ZONESTAR3D/Control-Board/readme.md

## ZONESTAR 3D Printer Control board documents 
### [8-bit Control board - ZMIB and ZRIB](./8bit/)
### [32-bitControl board - ZM3E2 and ZM3E4](./32bit/)
### [ZONESTAR 3D Printer LCD Screen](./LCD%20Screen/)
