ZONESTAR3D/Control-Board/8bit/readme.md

## ZMIB 3d printer control board
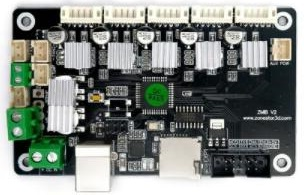
[picture p1: 8bit/ZMIB.jpg]
ZMIB
    
- **[:arrow_down: Documents for ZMIB 3d printer control board](./ZMIB.zip)**
- **:file_folder: Firmware**     
If you need to compile your own firmware, you can refer to the firmware source code of our machine which used ZMIB control board.
  - **[Firmware for Z5](https://github.com/ZONESTAR3D/Firmware/blob/master/Z5/ZMIB)**   
  - **[Firmware for Z5X](https://github.com/ZONESTAR3D/Firmware/tree/master/Z5X/ZMIBV2)**   
  - **[Firmware for Z6](https://github.com/ZONESTAR3D/Firmware/tree/master/Z6/ZMIBV2)**    

----
## ZRIB 3d printer control board
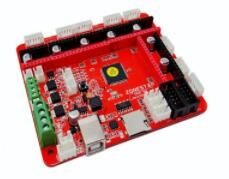
[picture p2: 8bit/ZRIB.jpg]
ZRIB
    
- **[:arrow_down: Documents for ZRIB 3d printer control board](./ZRIB.zip)**   
- **:file_folder: Firmware**     
If you need to compile your own firmware, you can refer to the firmware source code of our machine which used ZRIB control board.
  - **[Firmware for Z8T](https://github.com/ZONESTAR3D/Firmware/tree/master/Z8/Z8T/ZRIBV6(default))**   
  - **[Firmware for Z9M3](https://github.com/ZONESTAR3D/Firmware/tree/master/Z9/Z9M3/ZRIBV6)**    

----
## USB to UART Driver
Both ZMIB and ZRIB used a CP2102 "USB to UART Bridge Virtual COM Port" chip, when you connect the control board to the USB port of the PC, you may need to install its driver.
#### [Driver download link](https://www.silabs.com/developers/usb-to-uart-bridge-vcp-drivers)
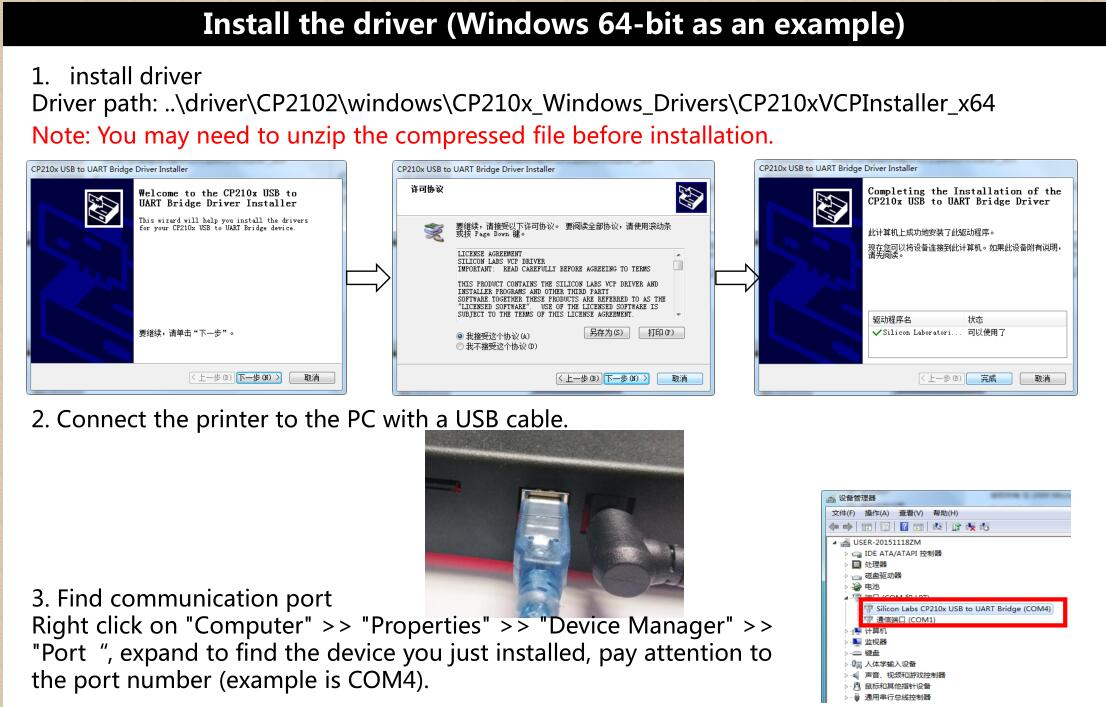
[picture p3: 8bit/Install_Driver.jpg]


----
## Upload Firmware
You can upload firmware to the ZRIB and ZMIB control boards by USB port of the PC. For details, please refer to this link: https://github.com/ZONESTAR3D/Firmware/tree/master/Firmware_Upload_tool_for_ZRIB_ZMIB
