ZONESTAR3D/Control-Board/32bit/ZM3E2/readme.md

# ZM3E2  
## Board Size  
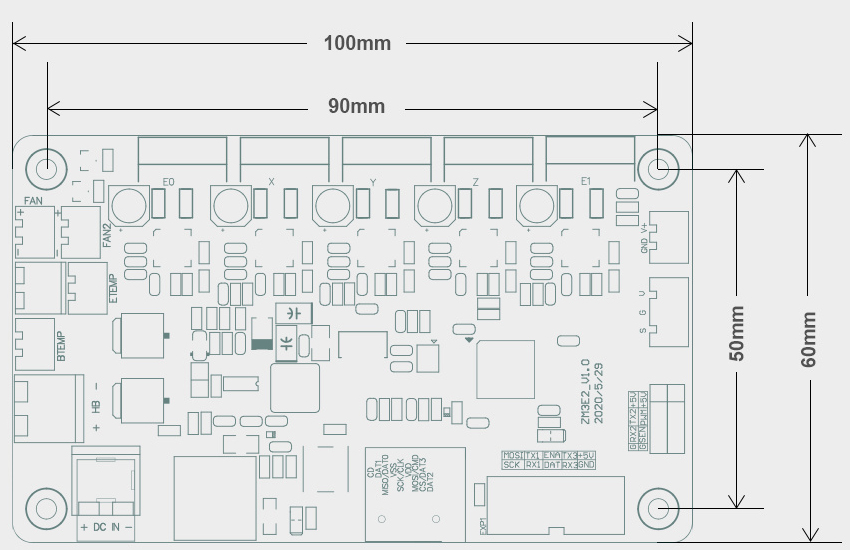
[picture p6: 32bit/ZM3E2/Size_ZM3E2.jpg]
Size
  

## Schematic diagram [:arrow_down: PDF](./SCH_ZM3E2V1.pdf)  
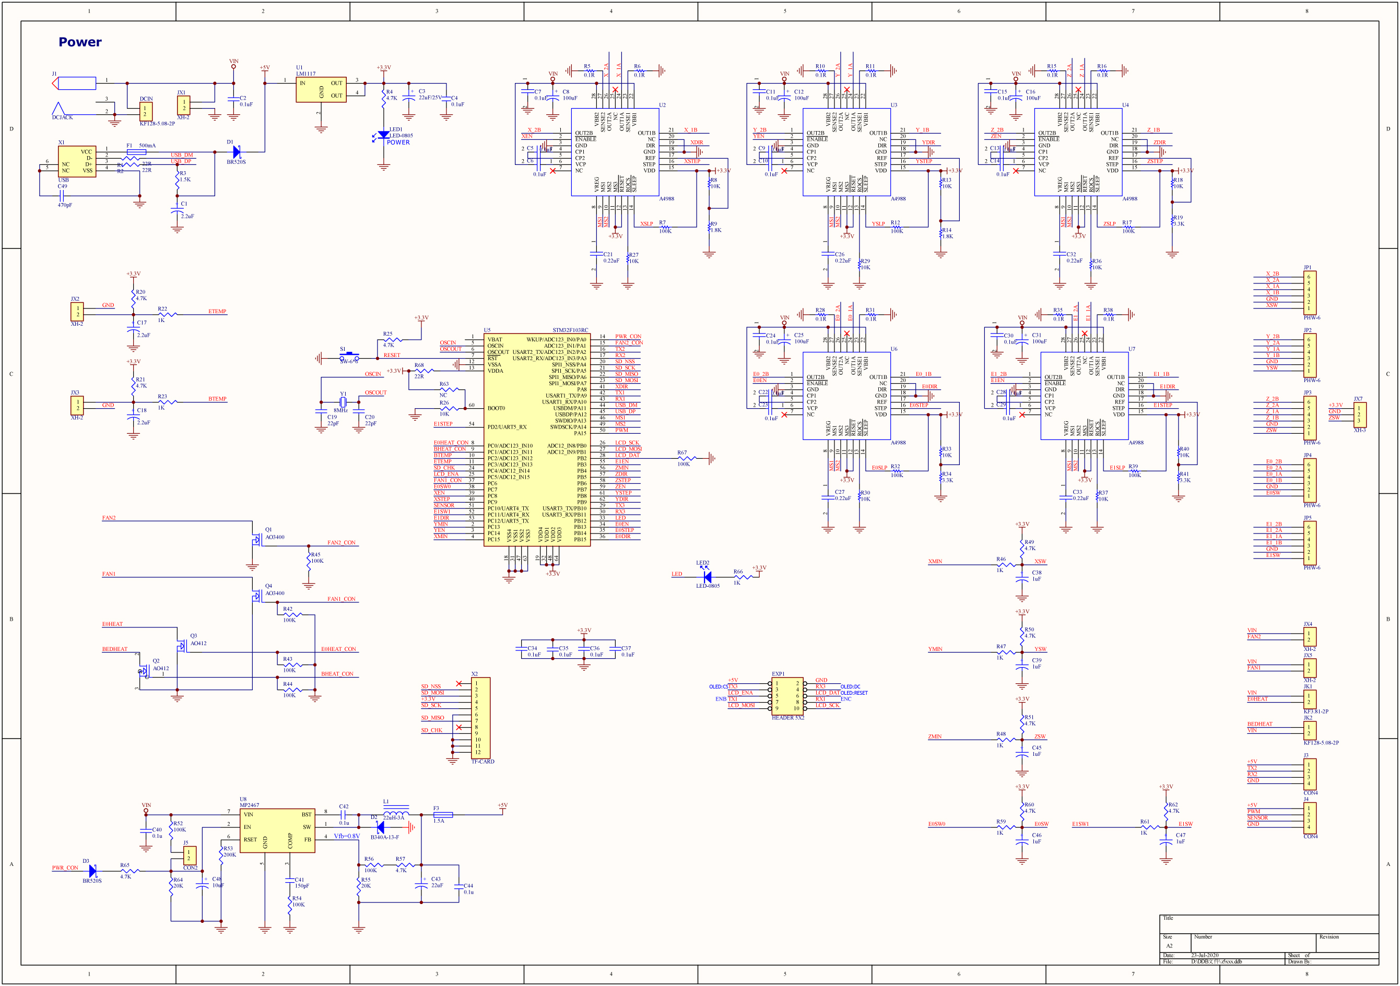
[picture p7: 32bit/ZM3E2/SCH_ZM3E2V1.jpg]
schematic diagram


## Pin out [:arrow_down: PDF](./PINOUT_ZM3E2V1.pdf)
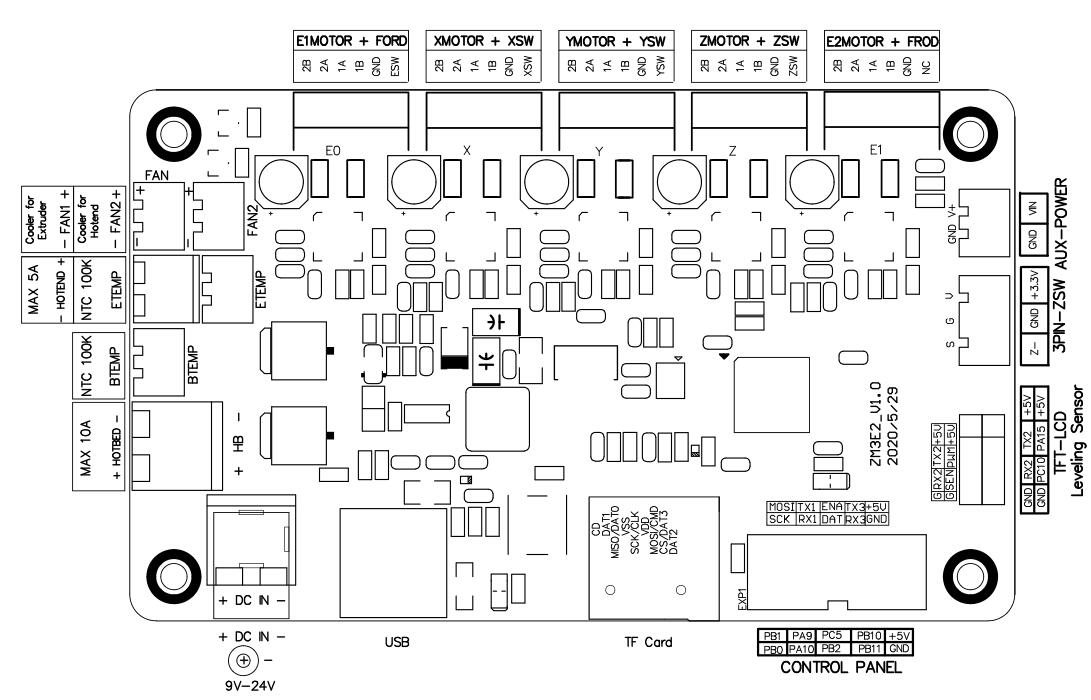
[picture p8: 32bit/ZM3E2/PINOUT_ZM3E2V1.jpg]
PINOUT
  

## PCB
### Designator   [:arrow_down: PDF](./designtor.pdf)
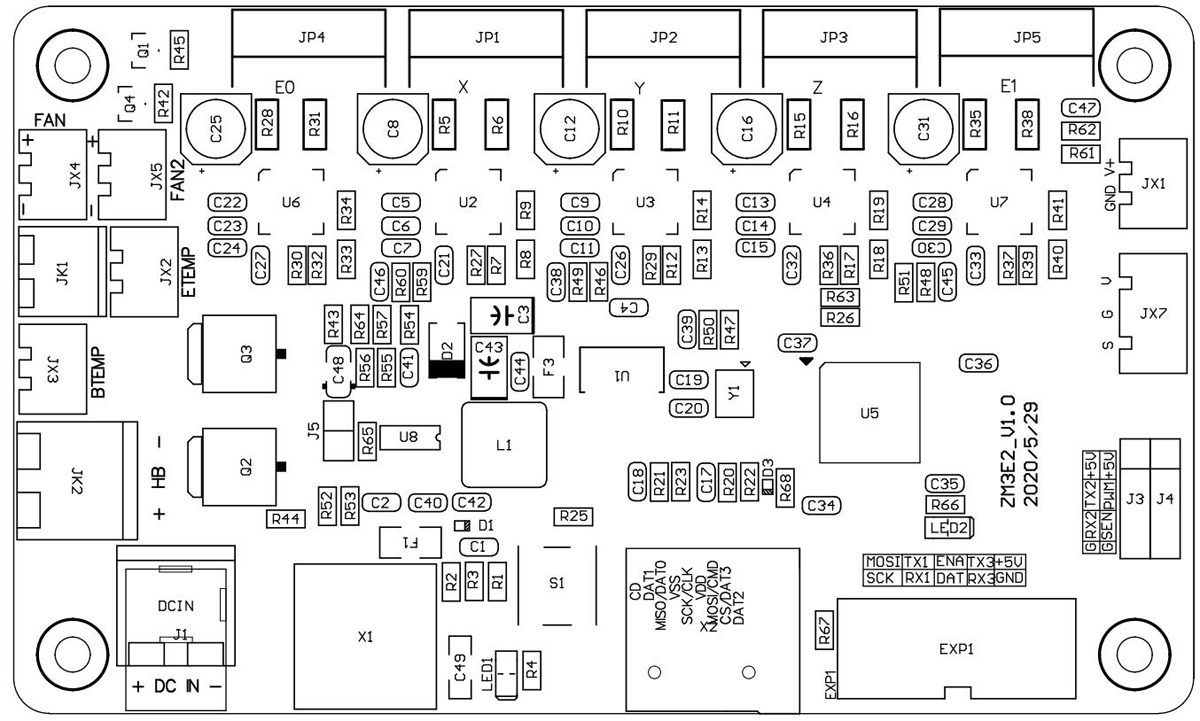
[picture p9: 32bit/ZM3E2/designator.jpg]
Designator
  
### Parts [:blue_book:PDF](./parts.pdf)
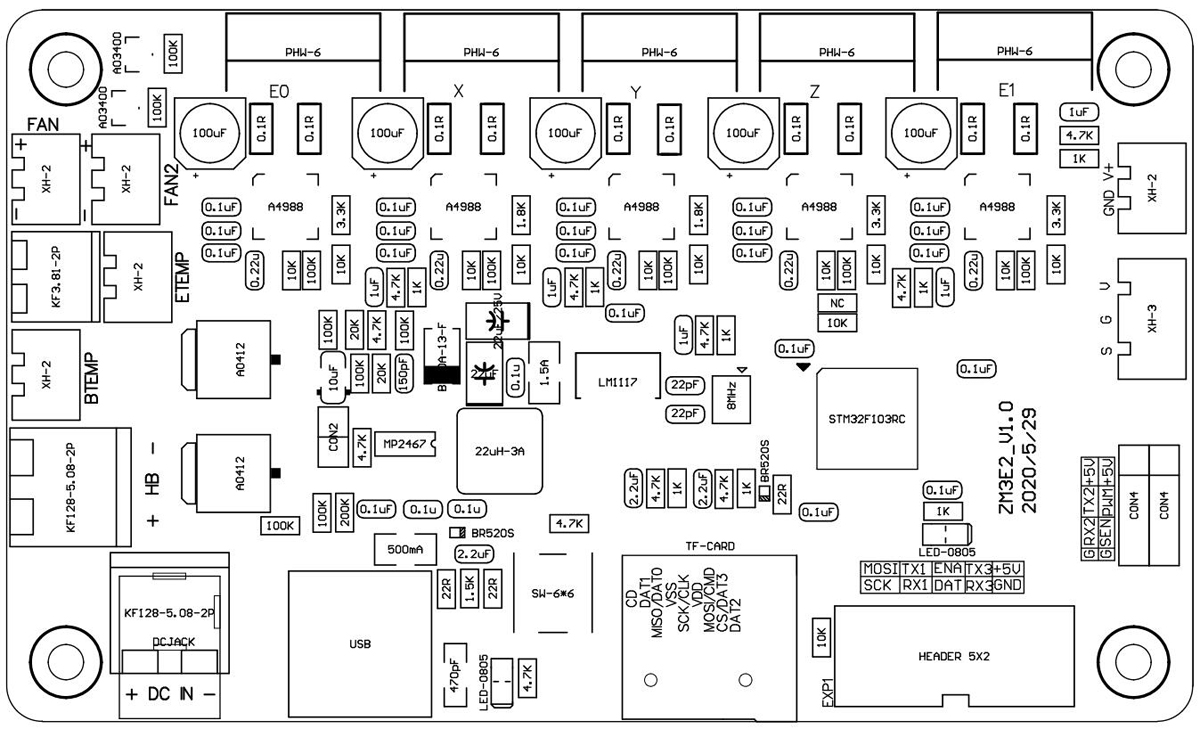
[picture p10: 32bit/ZM3E2/parts.jpg]
Parts
  

## Pin define  
please refer to the file: [***pins_ZM3E2_V1_0.h***](https://github.com/ZONESTAR3D/Control-Board/blob/main/32bit/ZM3E2/pins_ZM3E2_V1_0.h)  
## Wiring reference
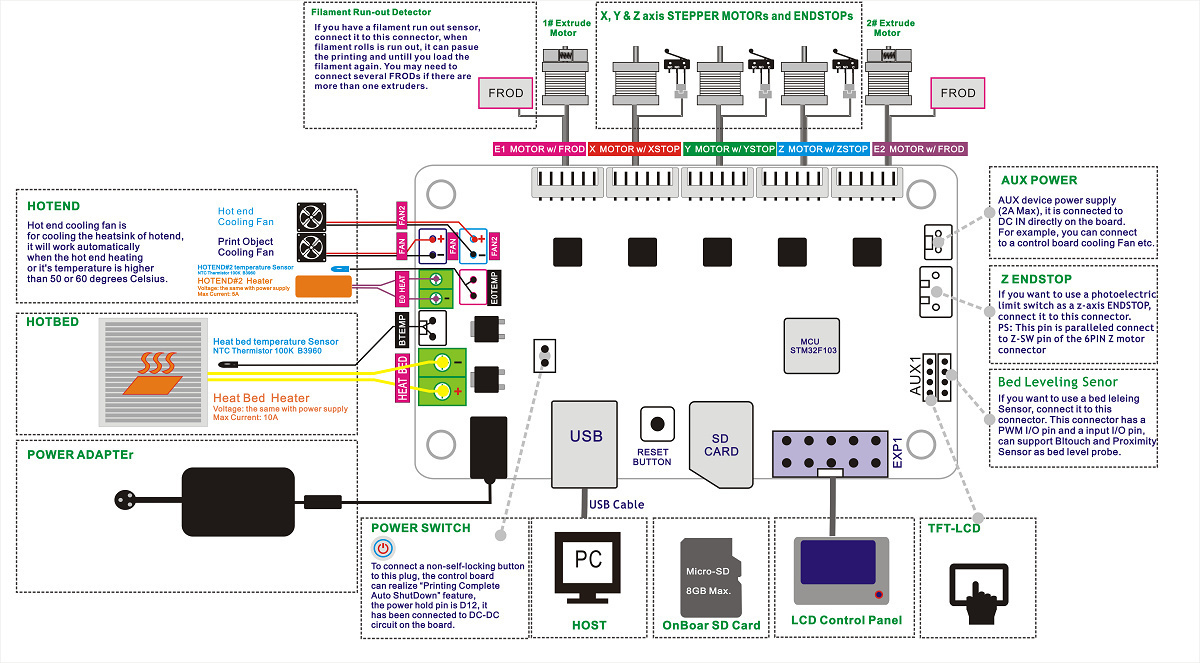
[picture p11: 32bit/ZM3E2/Wiring_ZM3E2V1.jpg]
Wiring
  

## Bootloader
### How to programming bootloader of the ZM3E2 control board
### [:arrow_down: Download ZM3E2 bootloader file](./ZM3E2_Bootloader.zip)
The steps for programming the bootloader are as follows:    
1. Short R63 (BOOT0 Pin of the MCU) with tweezers and then power on the control board.
2. Release the tweezers for shorting R63.
3. Programming the bootloader.     

For tools and detailed instructions, please refer to [:book: **the instructions for programming bootloader for ZM3E4**](https://github.com/ZONESTAR3D/Control-Board/blob/main/32bit/ZM3E4/flashBootloader/readme.md).

#### The position of R63 on the control board
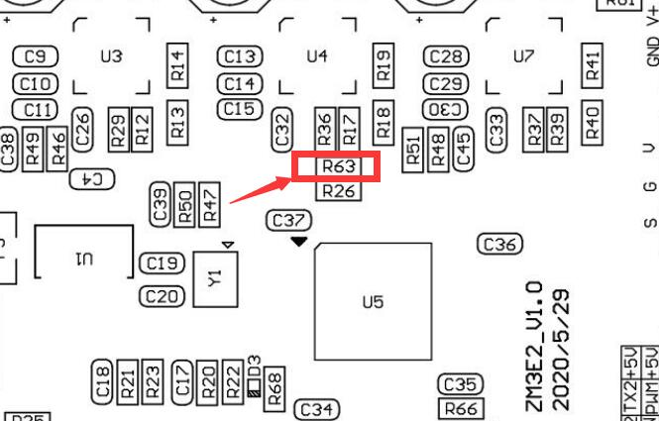
[picture p12: 32bit/ZM3E2/R63.jpg]

#### UART1 pins on the control board
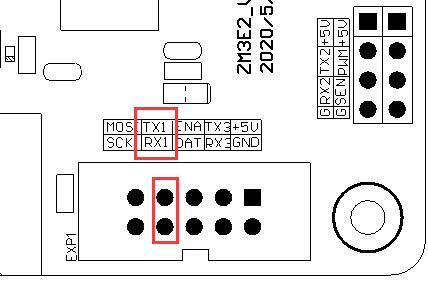
[picture p13: 32bit/ZM3E2/UART1.jpg]
