ZONESTAR3D/Control-Board/32bit/ZM3E4/flashBootloader/5.jpg

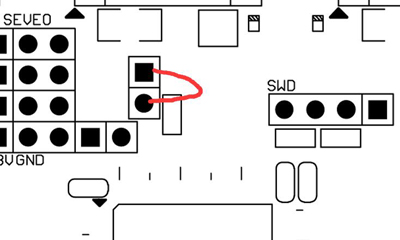
32bit/ZM3E4/flashBootloader/5.jpg
