ZONESTAR3D/Control-Board/32bit/ZM3E4/ZM3E4V1/PCB_BOTTOM_ZM3E4_V1.jpg

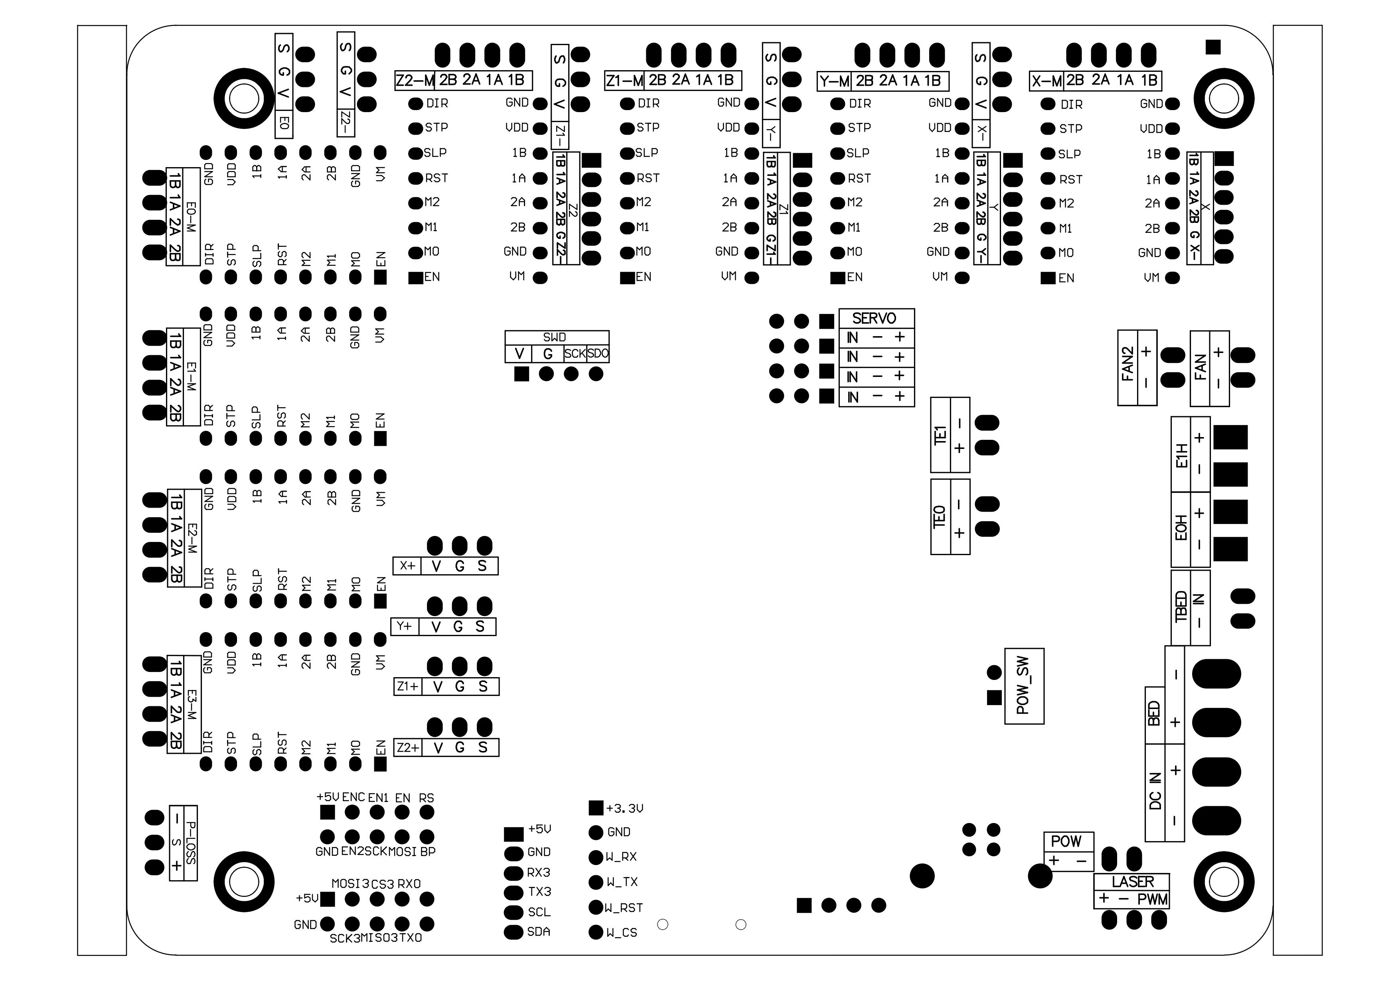
32bit/ZM3E4/ZM3E4V1/PCB_BOTTOM_ZM3E4_V1.jpg
