ZONESTAR3D/Control-Board/32bit/ZM3E4/ZM3E4V20/Designator_ZM3E4_V2.jpg

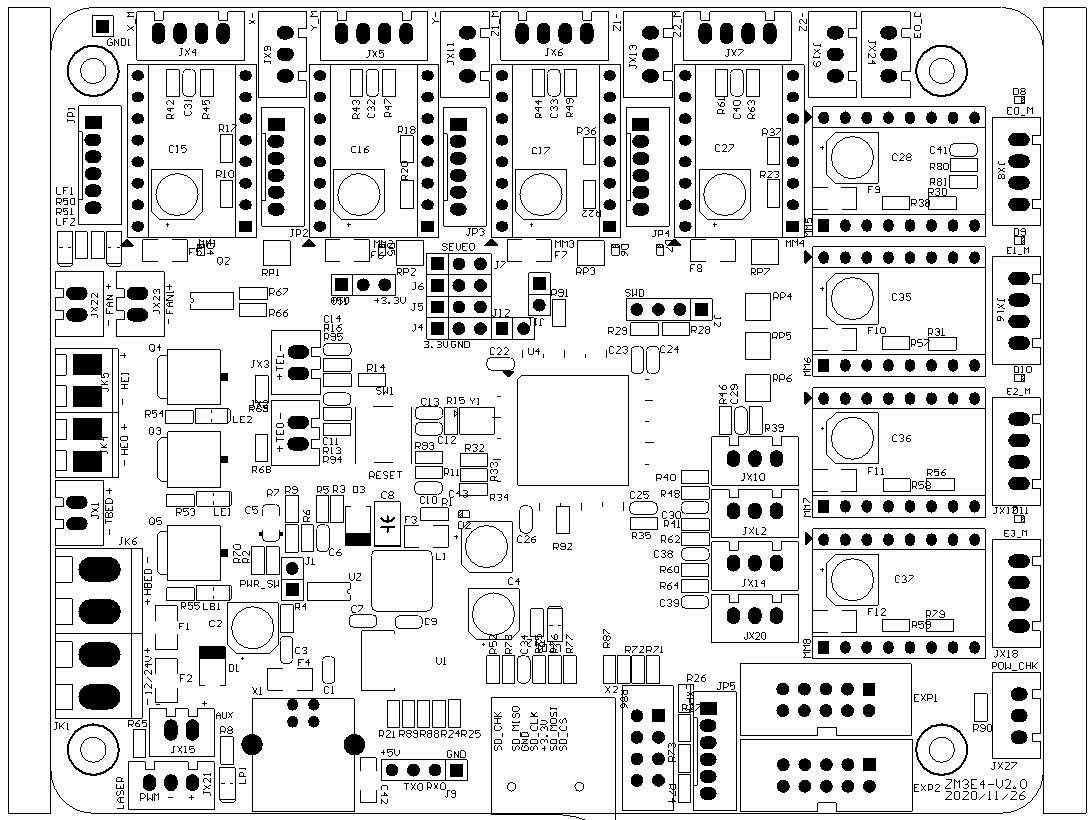
32bit/ZM3E4/ZM3E4V20/Designator_ZM3E4_V2.jpg
