ZONESTAR3D/Control-Board/32bit/ZM3E4/ZM3E4V20/PCB_TOP_ZM3E4_V20.jpg

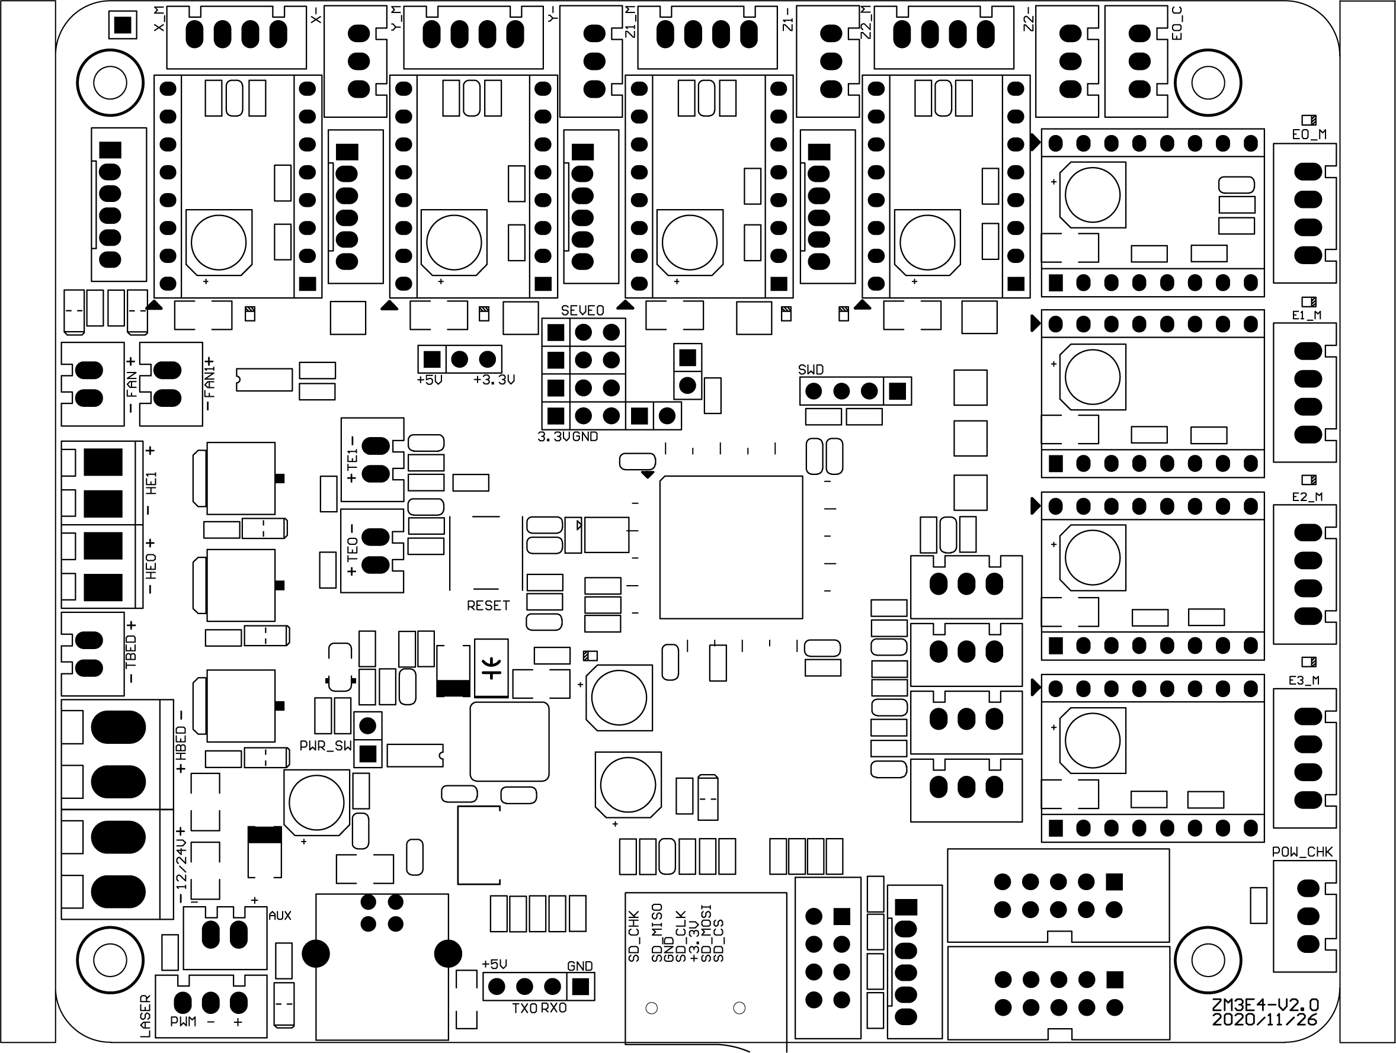
32bit/ZM3E4/ZM3E4V20/PCB_TOP_ZM3E4_V20.jpg
