ZONESTAR3D/Control-Board/32bit/ZM3E4/ZM3E4V20/SCH_ZM3E4V20.jpg

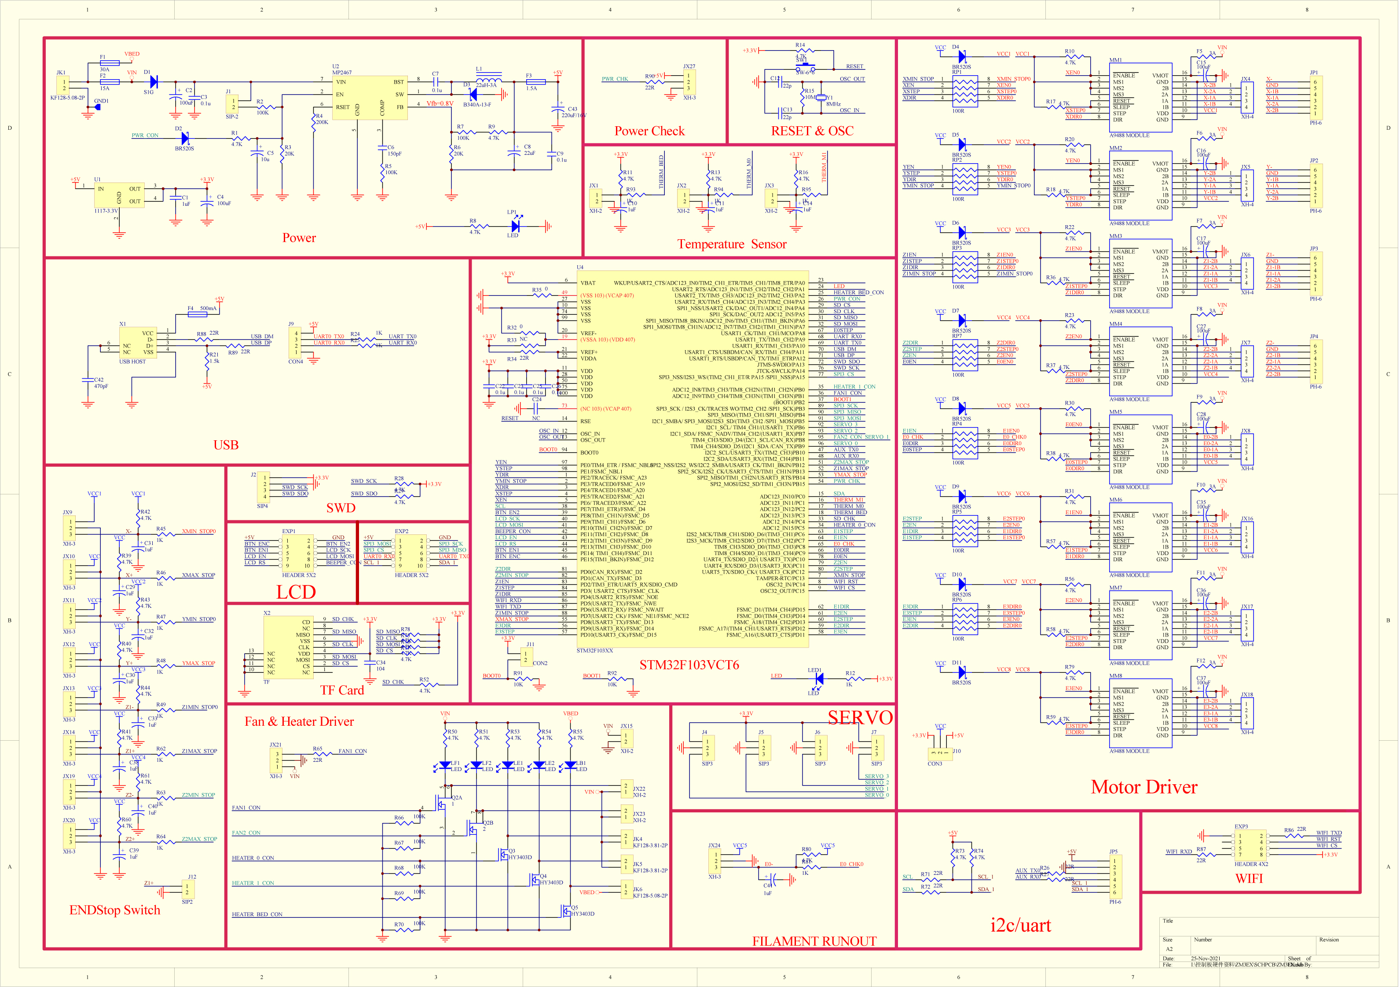
32bit/ZM3E4/ZM3E4V20/SCH_ZM3E4V20.jpg
