ZONESTAR3D/Control-Board/32bit/ZM3E4/zm3e4.stp

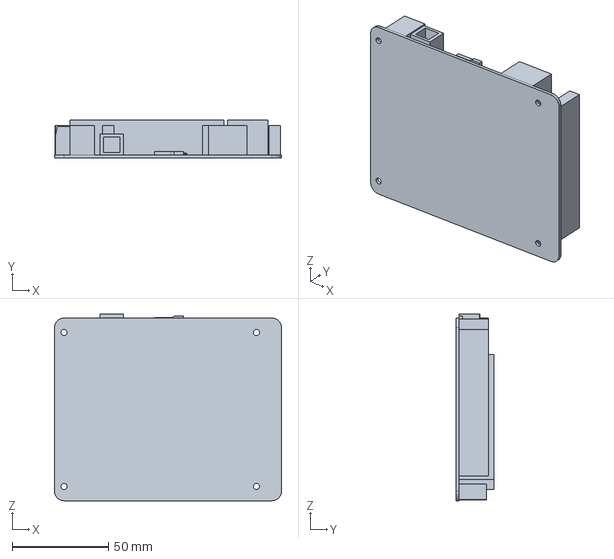
[picture p38: CAD file, 2021-11-25, last stored version]
32bit/ZM3E4/zm3e4.stp
118.0 x 20.0 x 97.0 mm
