ZONESTAR3D/Control-Board/32bit/ZM3E4/Wiring/ZM3E4_P802_Wiring_Diagram.jpg

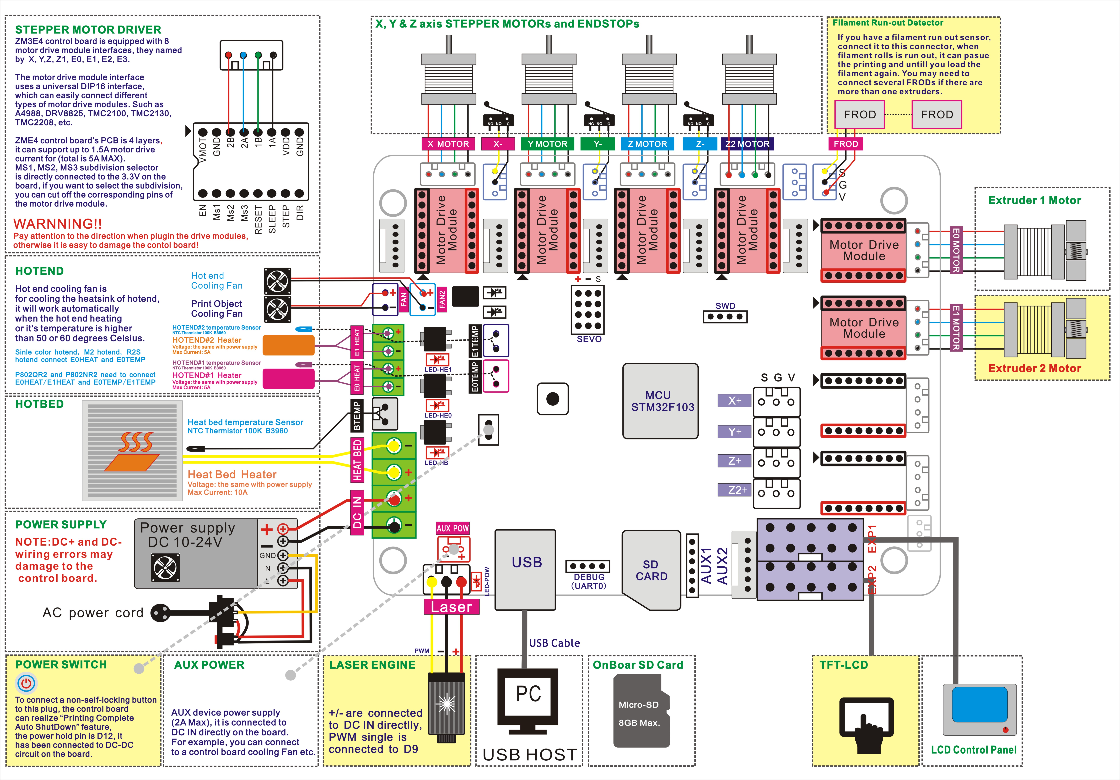
32bit/ZM3E4/Wiring/ZM3E4_P802_Wiring_Diagram.jpg
