ZONESTAR3D/Control-Board/32bit/ZM3E4/Wiring/ZM3E4_Wiring_Diagram_4PINMotorCable.jpg

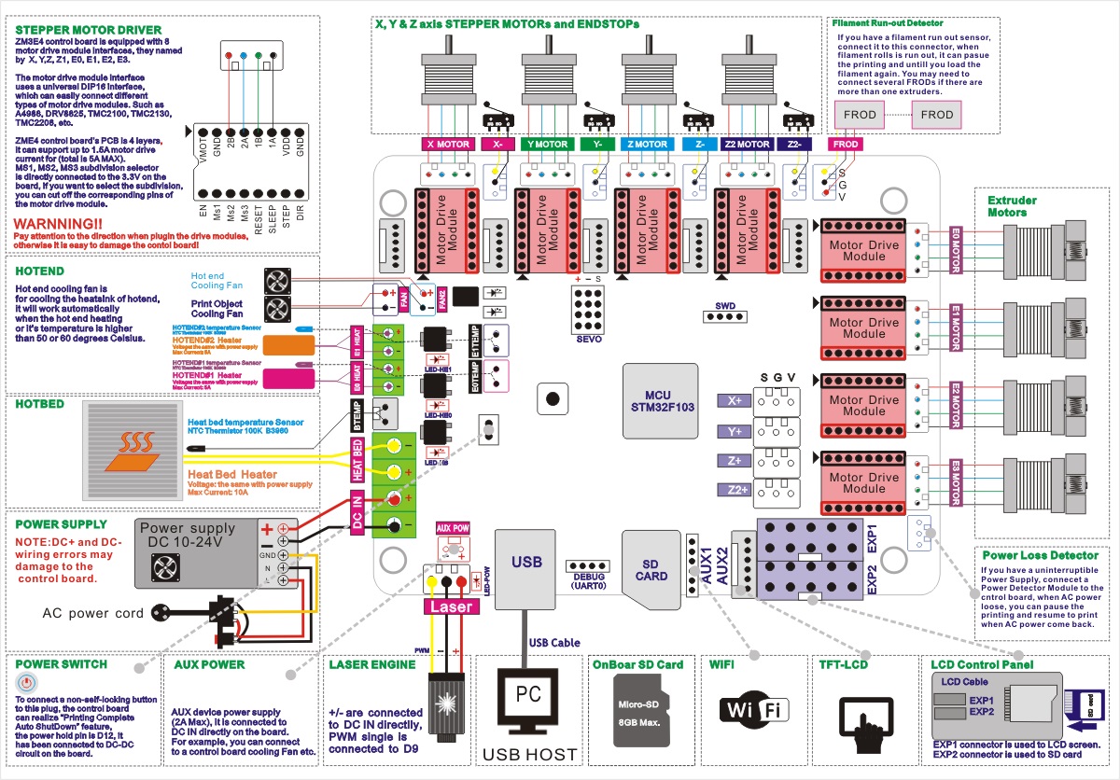
32bit/ZM3E4/Wiring/ZM3E4_Wiring_Diagram_4PINMotorCable.jpg
