ZONESTAR3D/Control-Board/32bit/ZM3E4/ZM3E4V3/ZM3E4V3_SCH.pdf

200K | Vfb=0.8V

# RESET & OSC

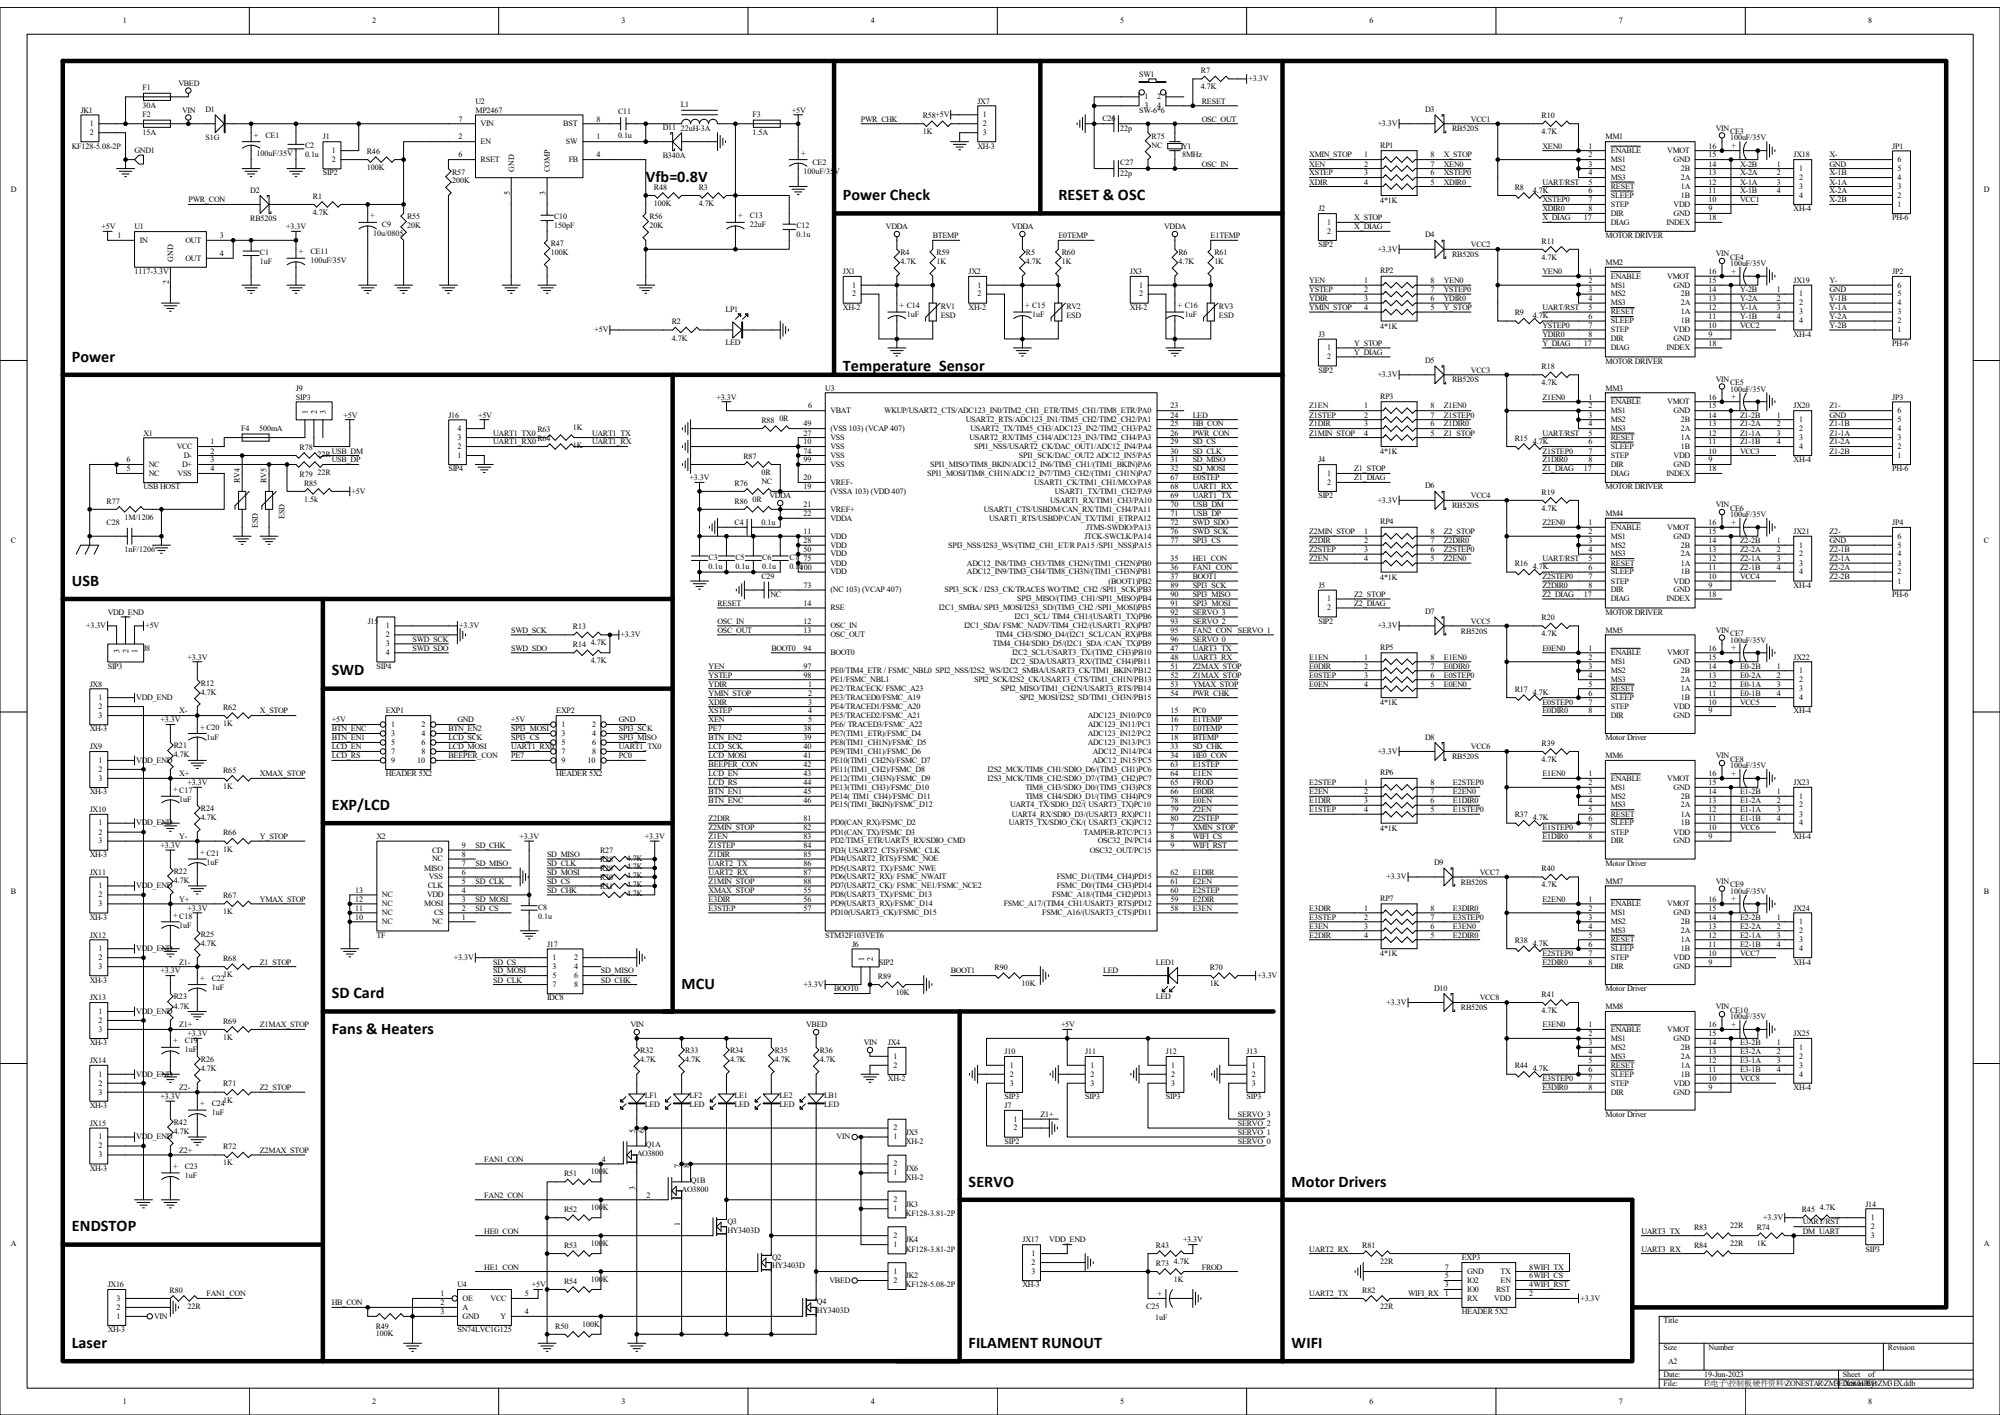
[picture p41: page 1]
