ZONESTAR3D/Control-Board/32bit/ZM3E4/ZM3E4V20/SCH_ZM3E4V20.pdf

### Vfb=0.8V

# RESET & OSC

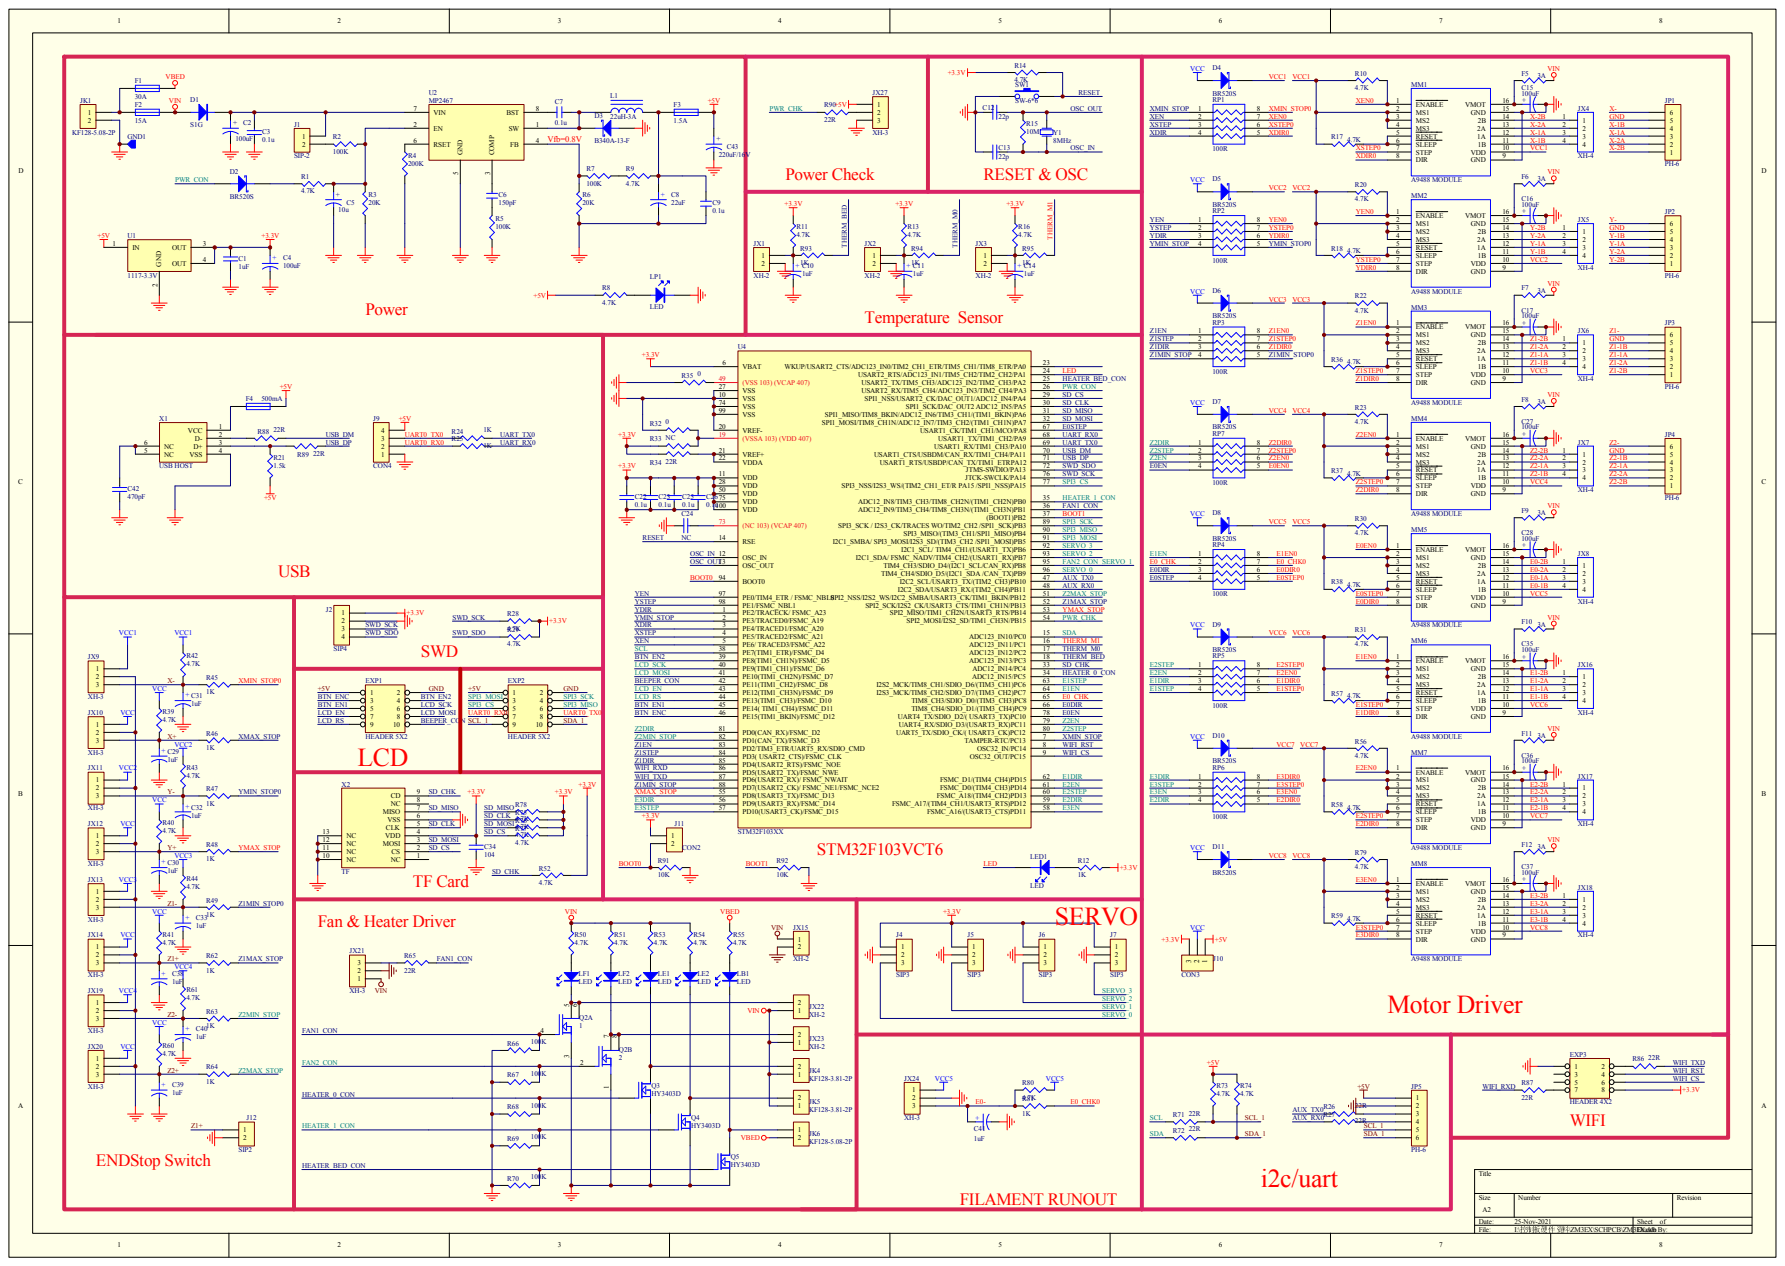
[picture p42: page 1]
