ZONESTAR3D/Control-Board/32bit/ZM3E4/ZM3E4V21/SCH_ZM3E4V21.pdf

### Vfb=0.8V

# RESET & OSC

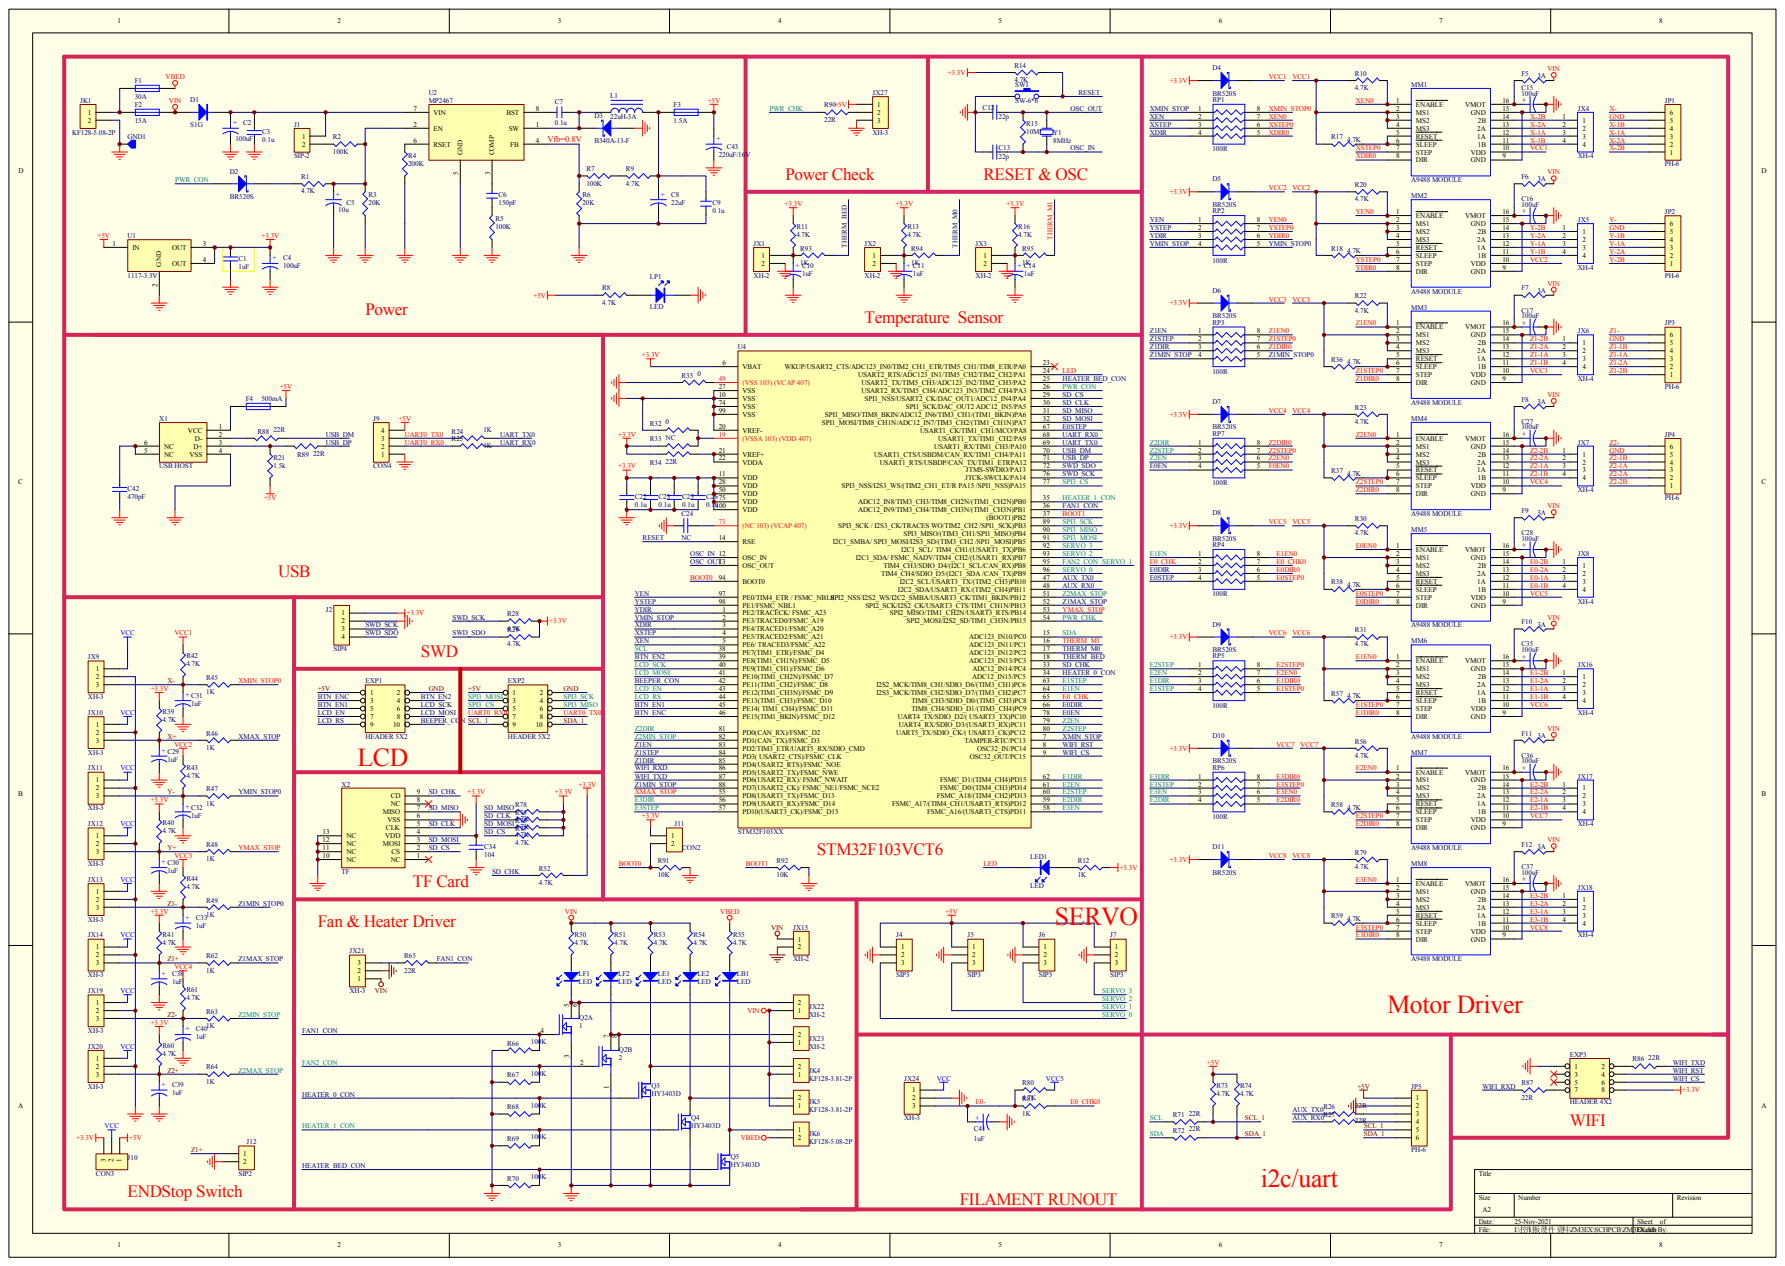
[picture p43: page 1]
