ZONESTAR3D/Control-Board/32bit/ZM3E2/designator.pdf

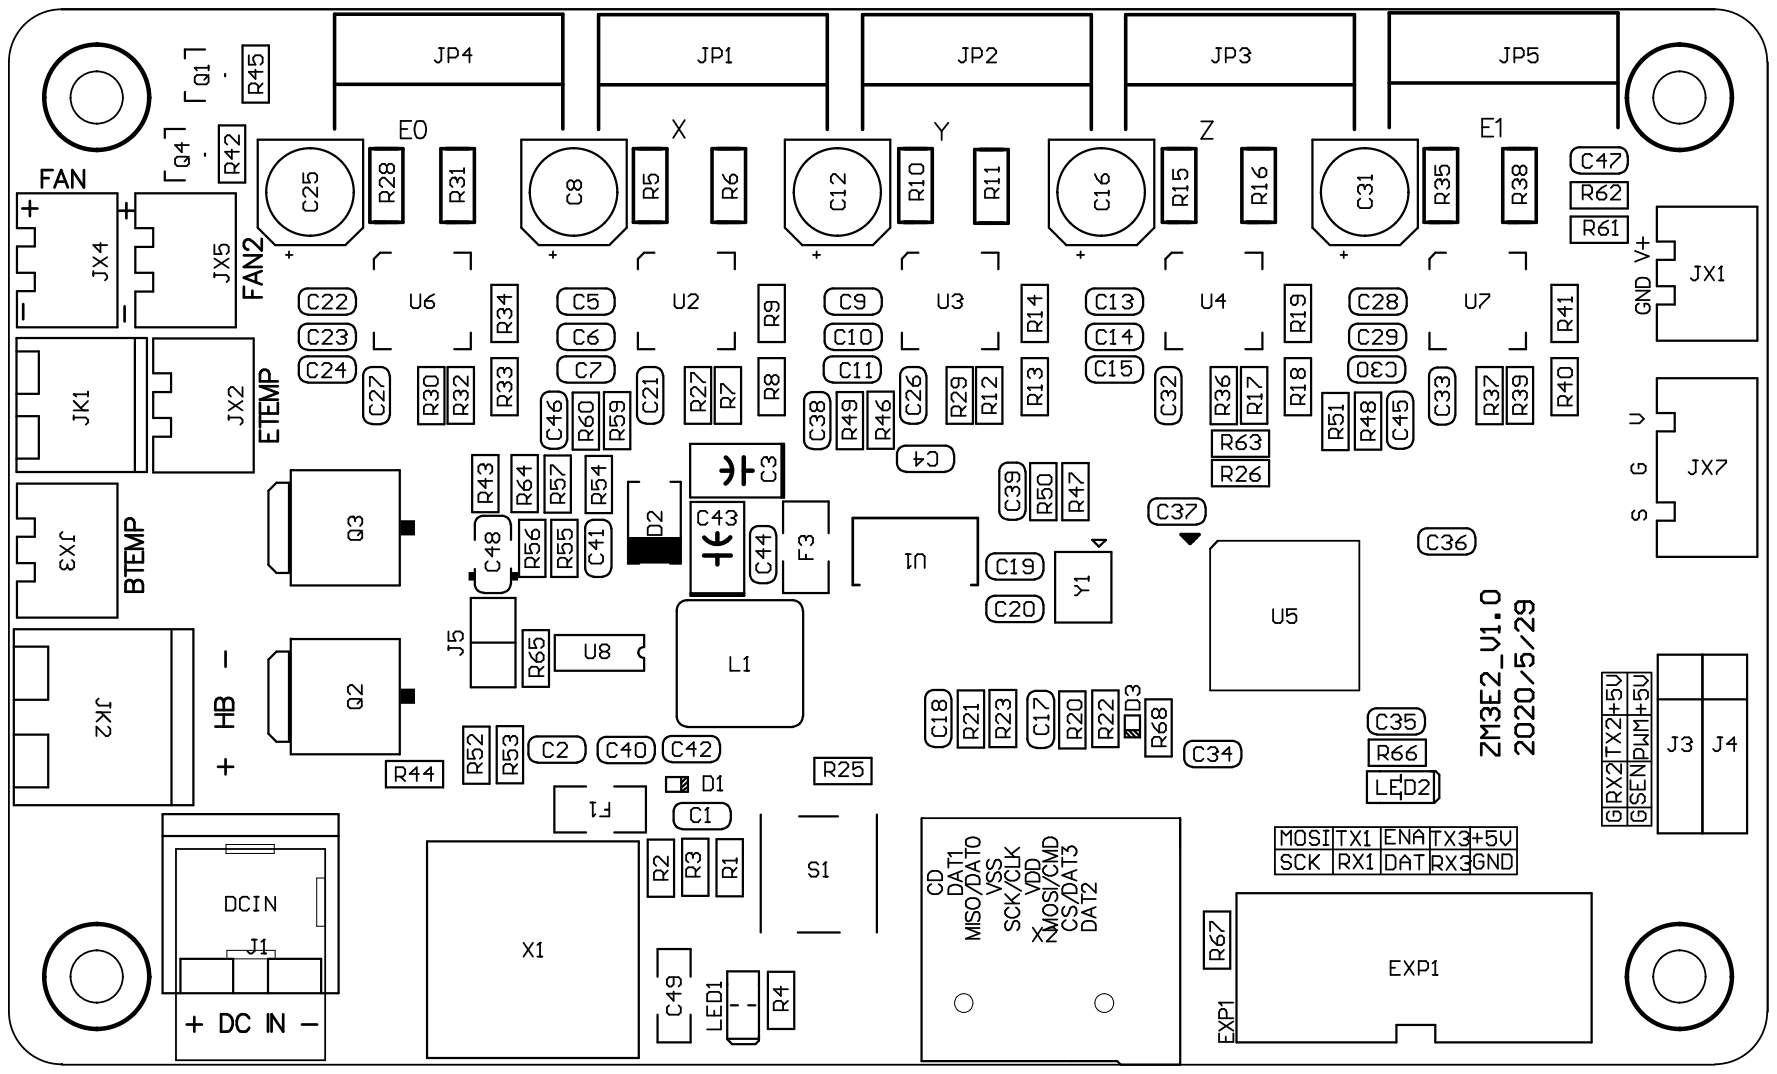
[picture p44: page 1]
