ZONESTAR3D/Control-Board/32bit/ZM3E2/parts.pdf

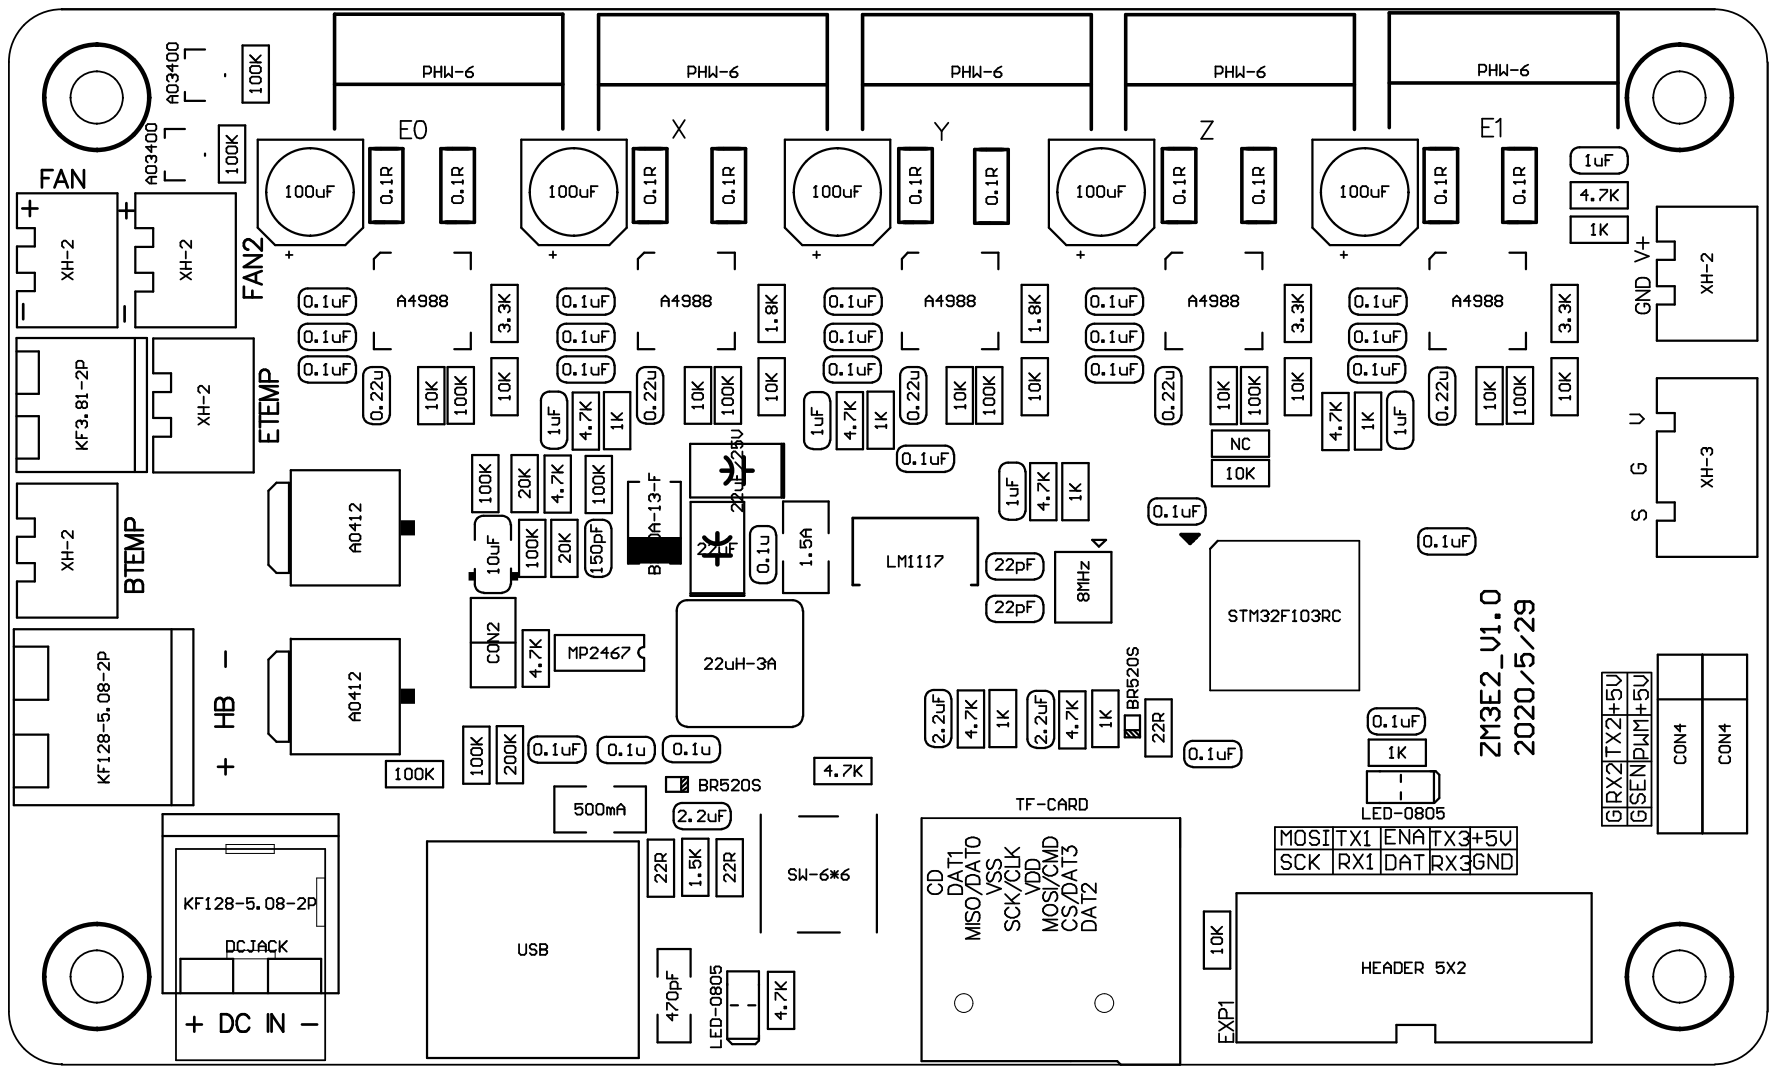
[picture p45: page 1]
