ZONESTAR3D/Control-Board/32bit/ZM3E4/ZM3E4V3/ZM3E4V3_Designator.pdf

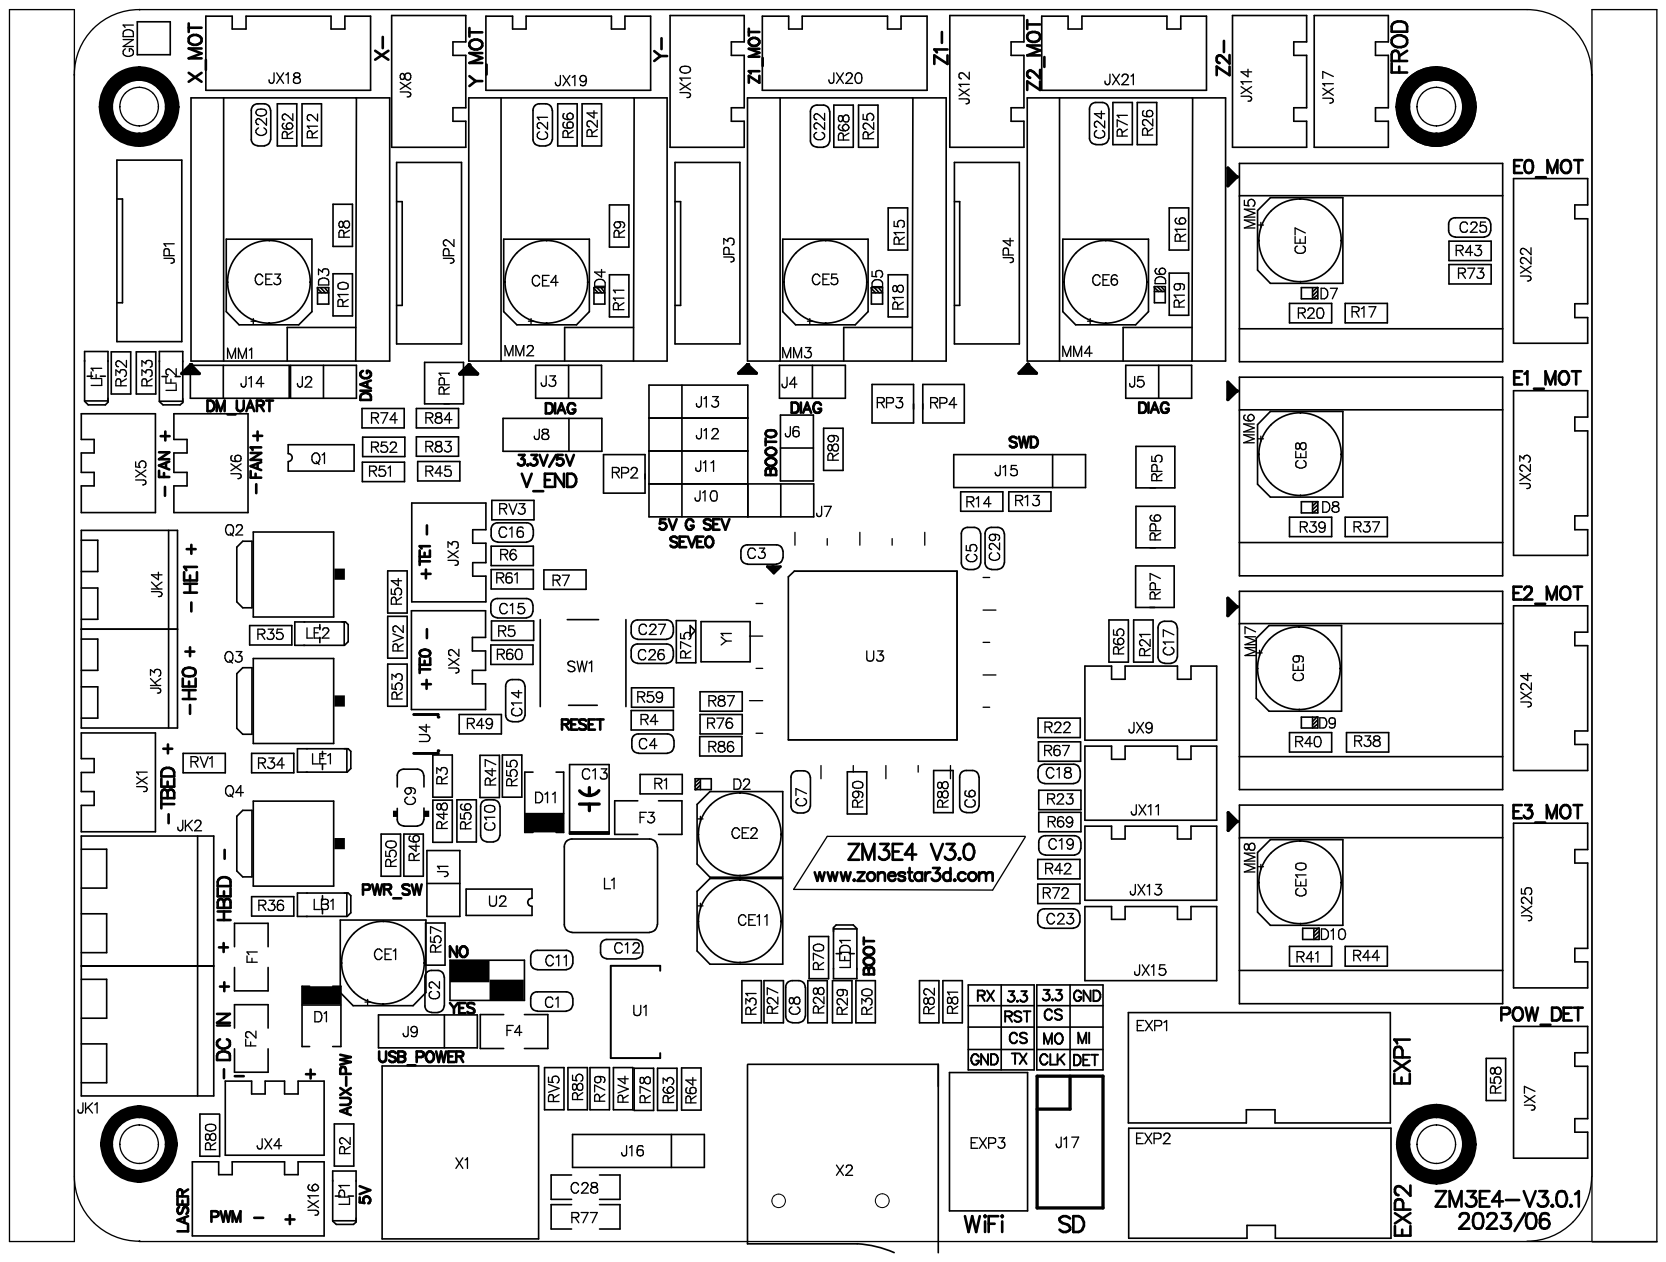
[picture p46: page 1]
