ZONESTAR3D/Control-Board/32bit/ZM3E4/ZM3E4V3/ZM3E4_V3_PCB.pdf

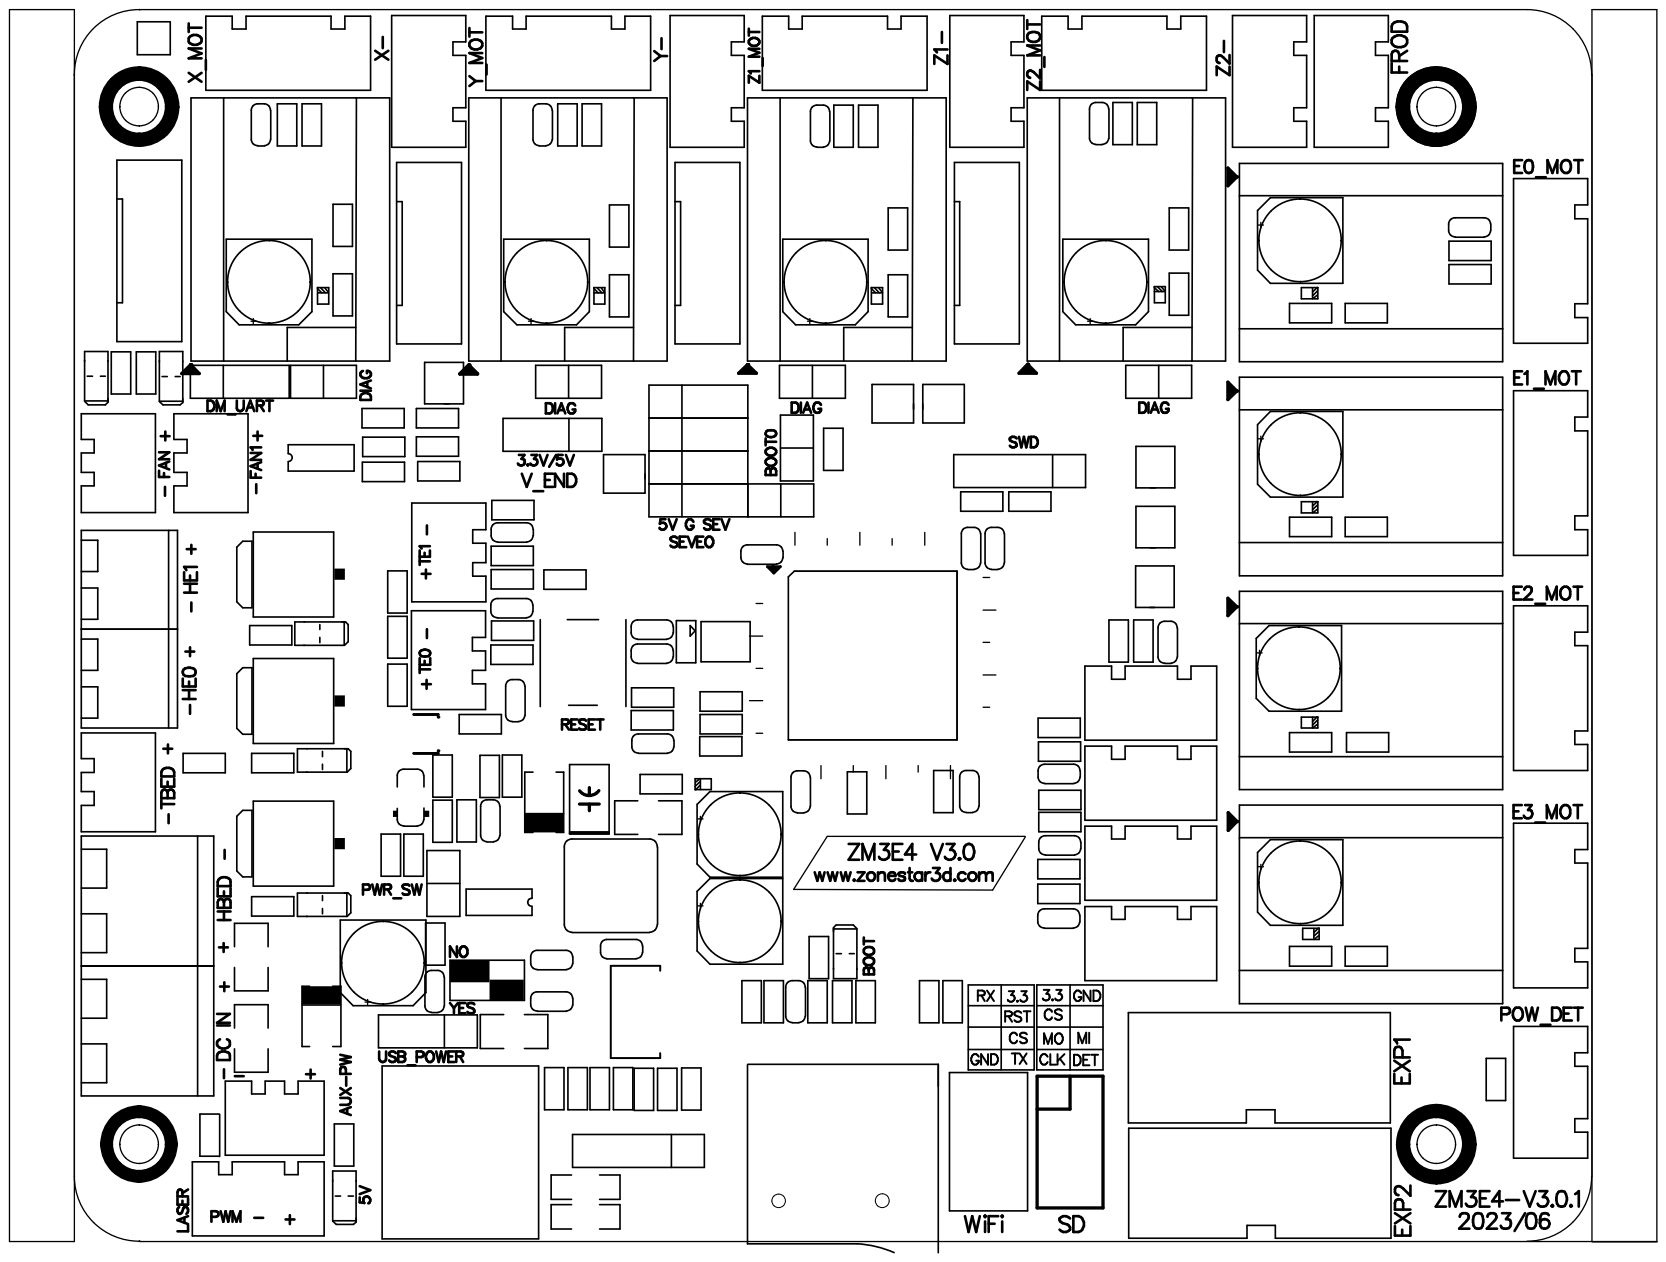
[picture p48: page 1]

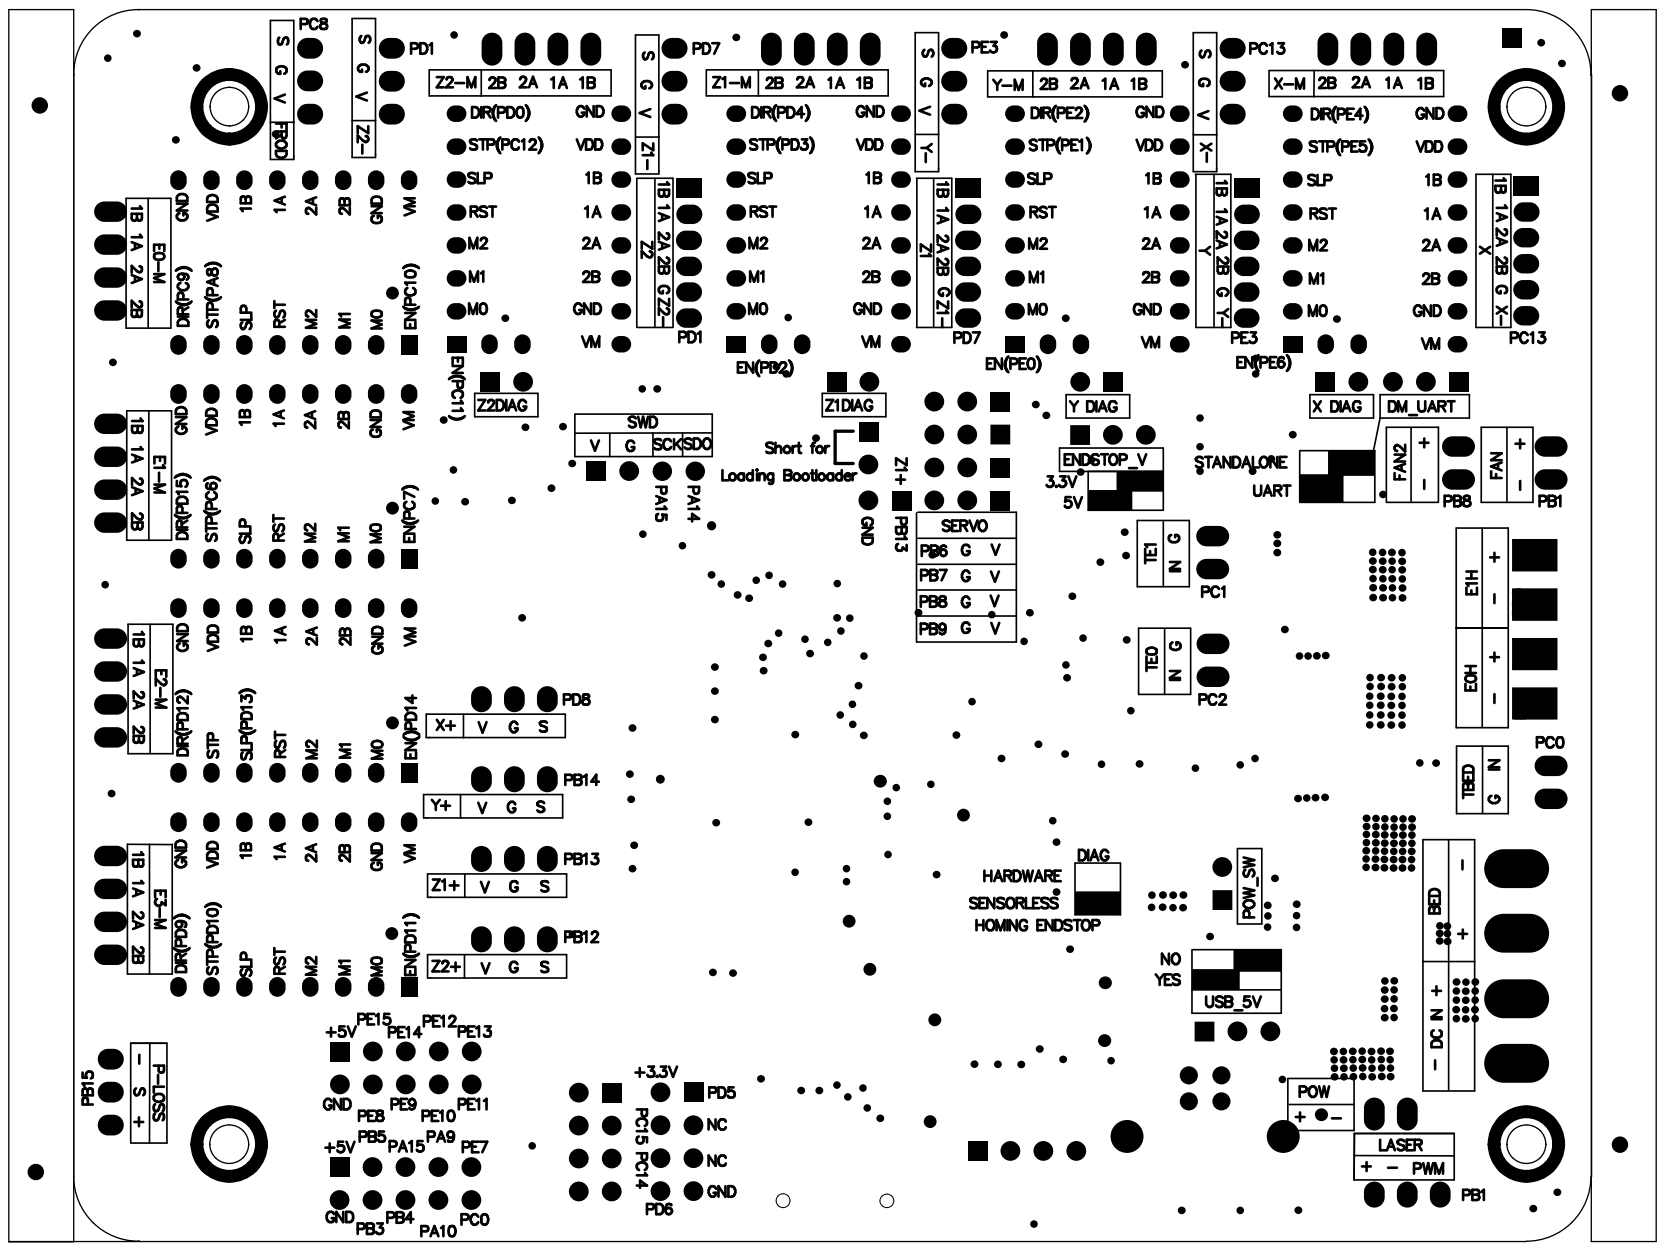
[picture p49: page 2]

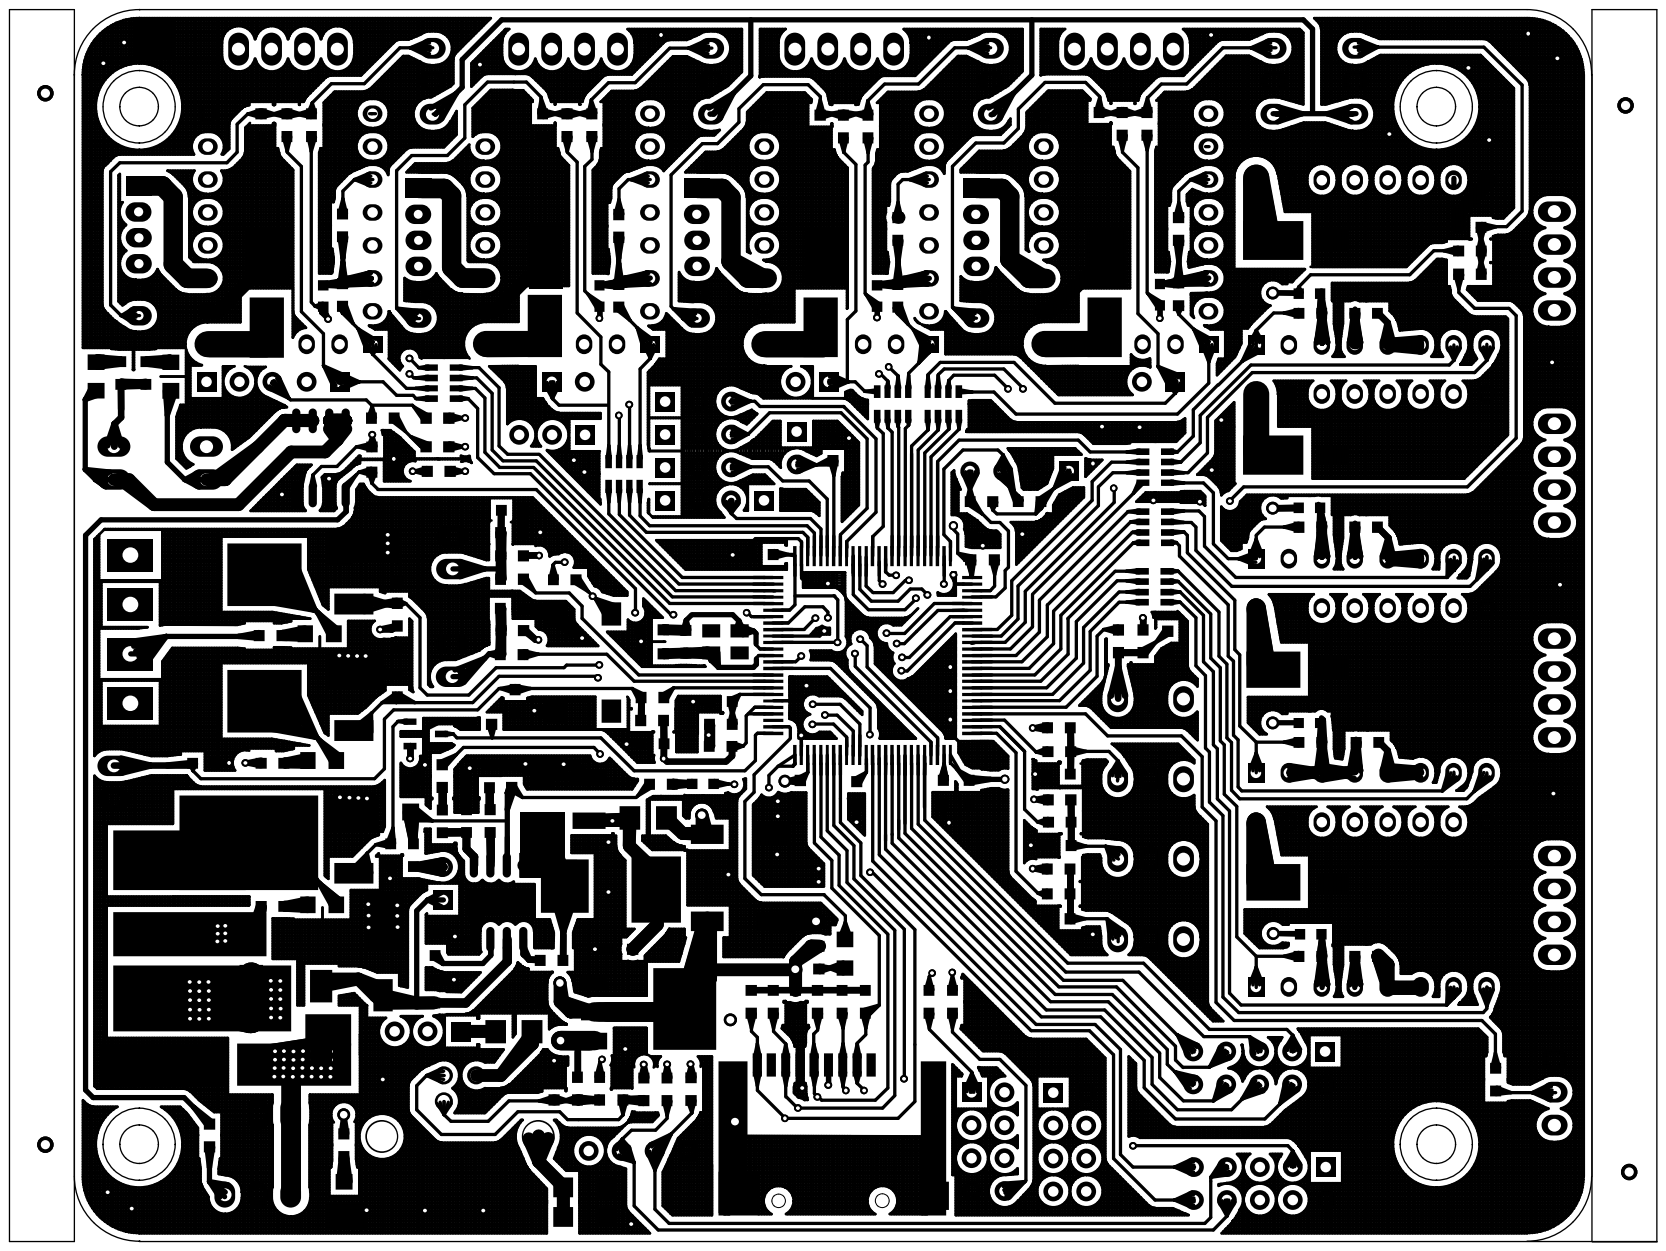
[picture p50: page 3]

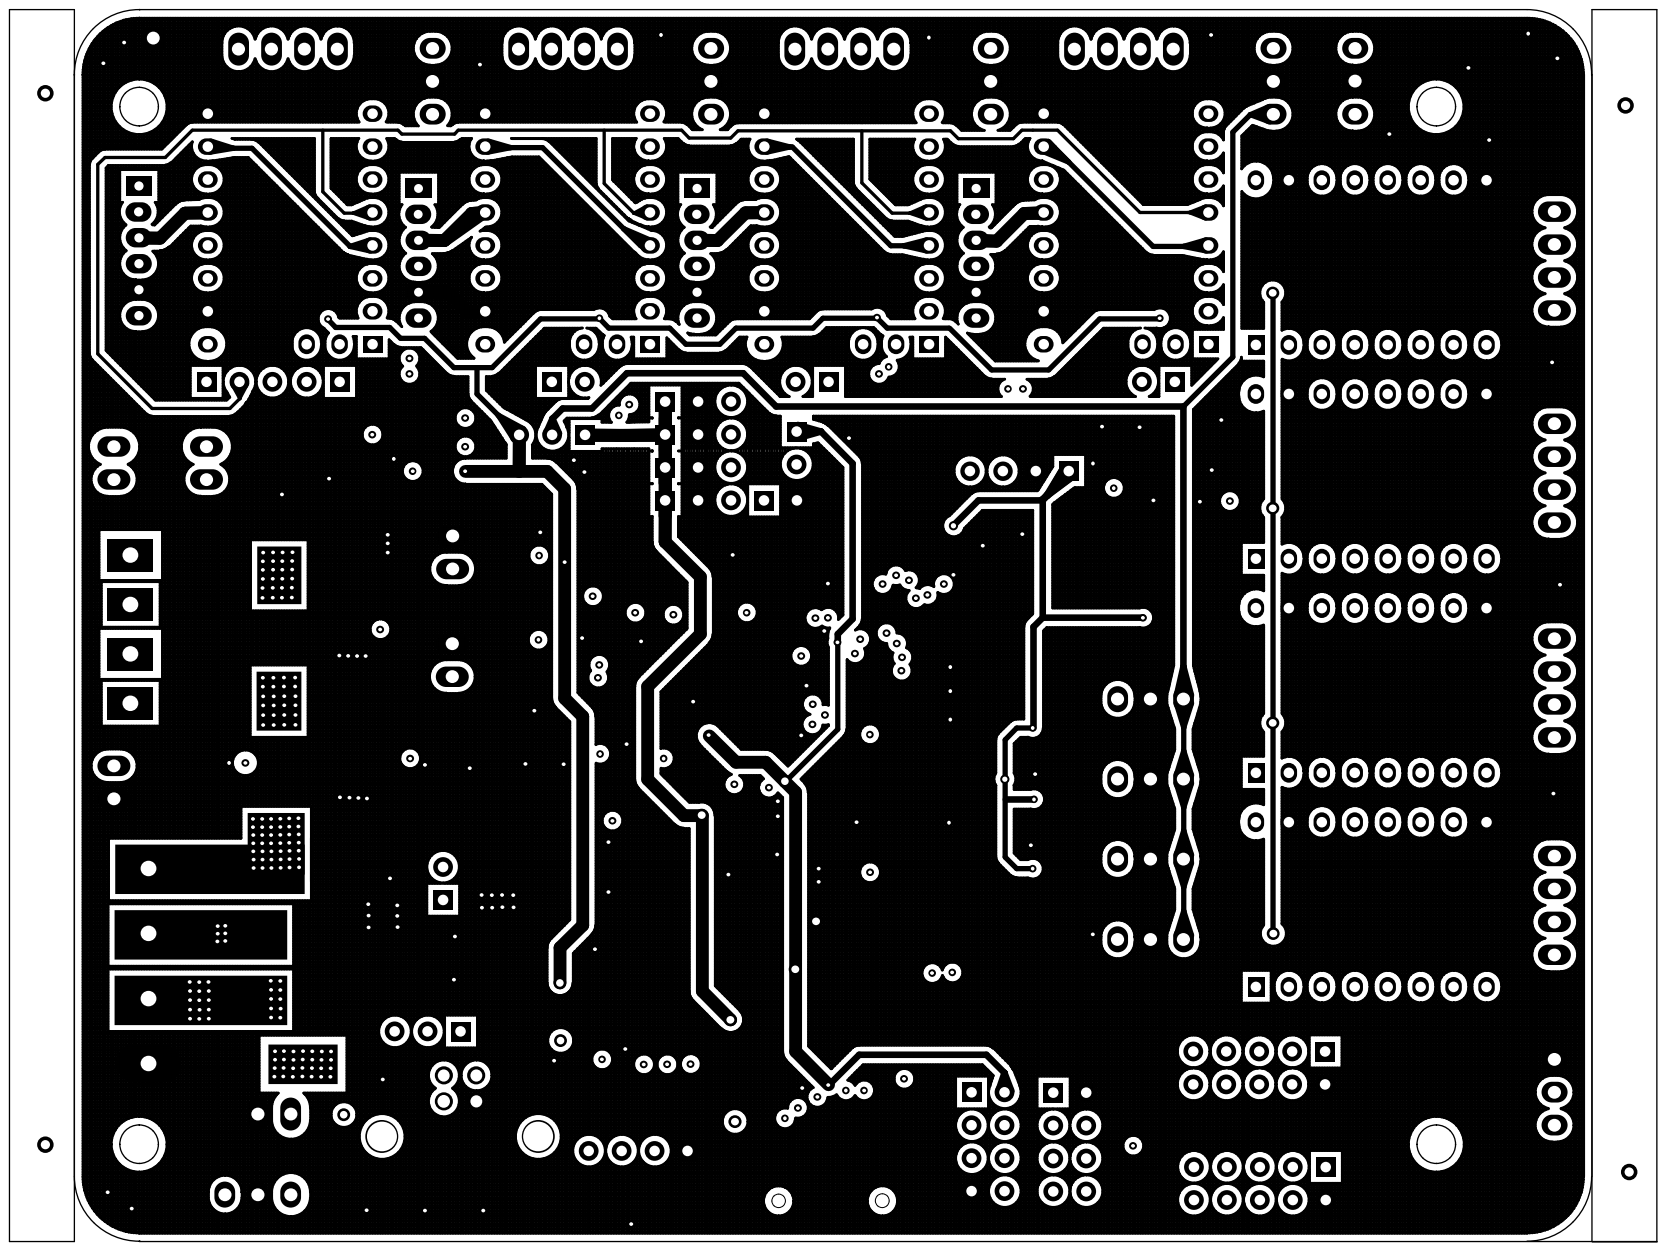
[picture p51: page 4]

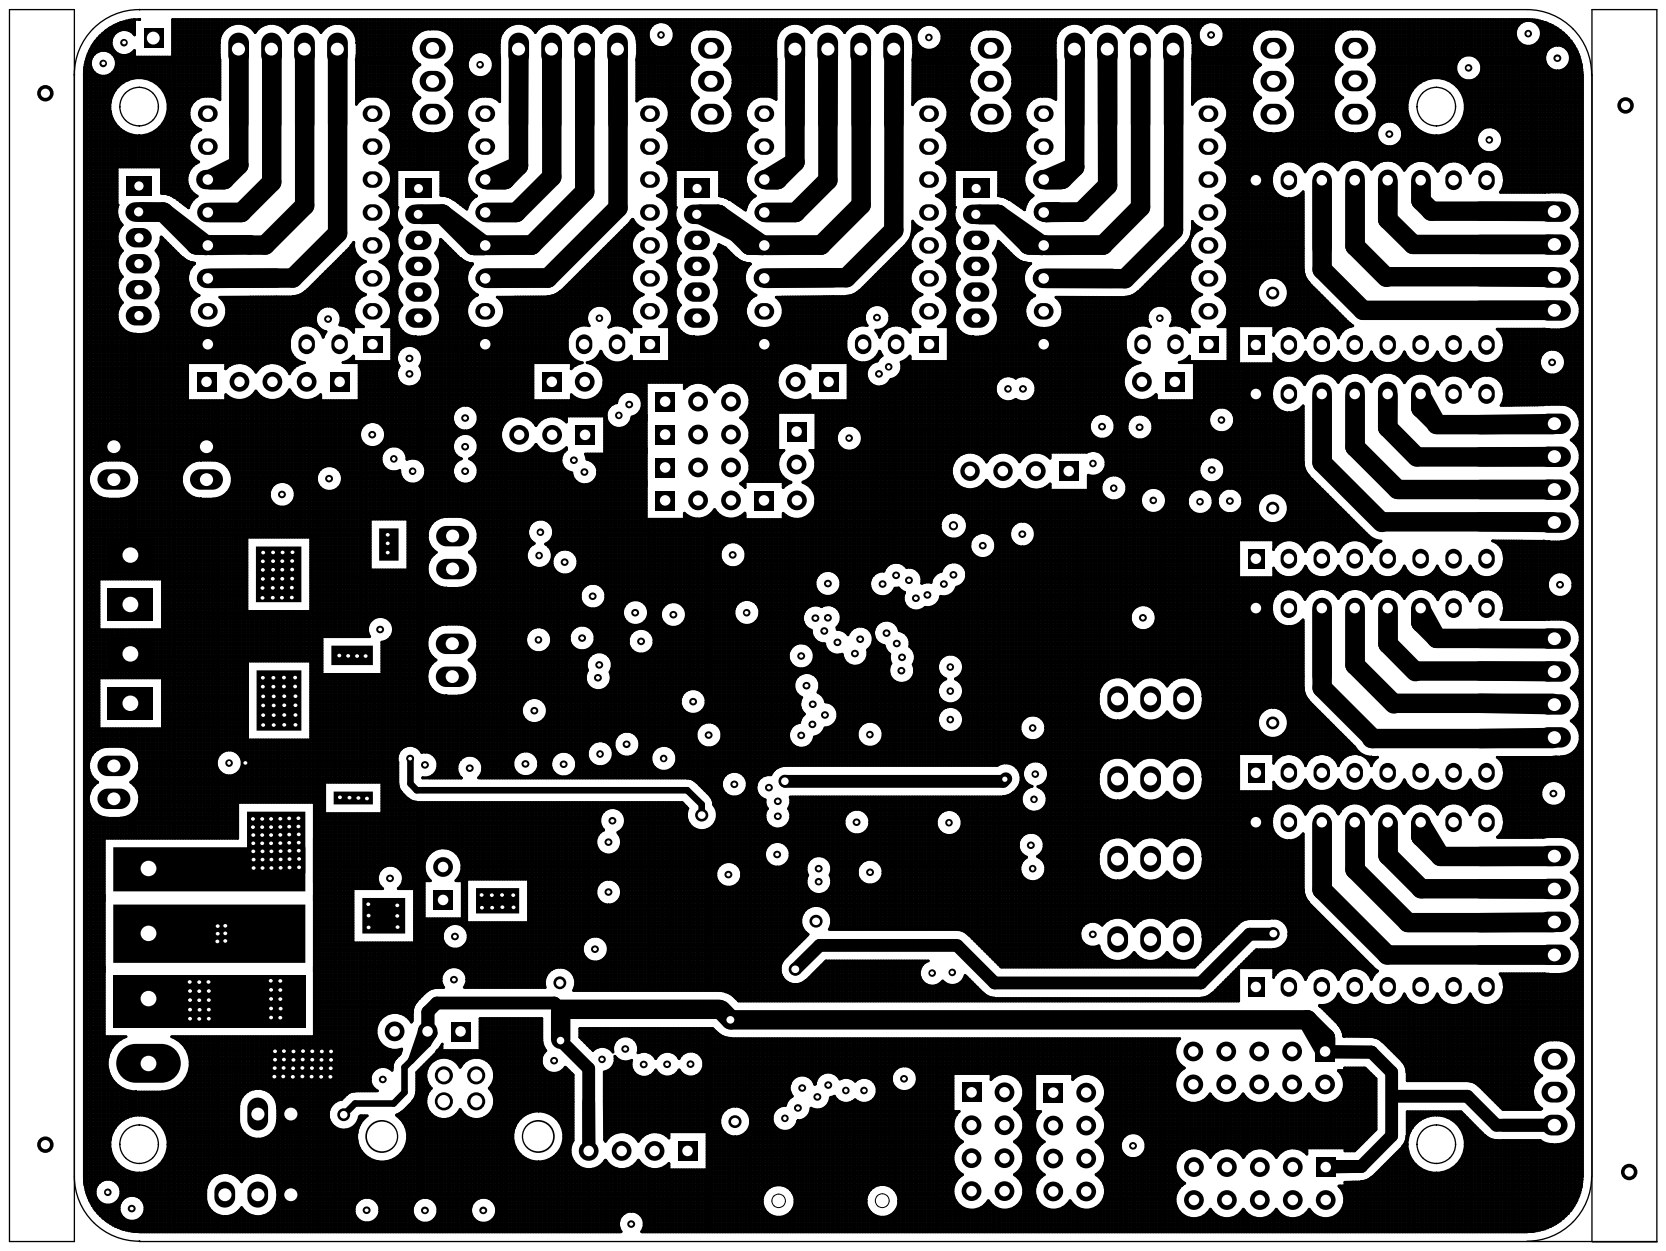
[picture p52: page 5]

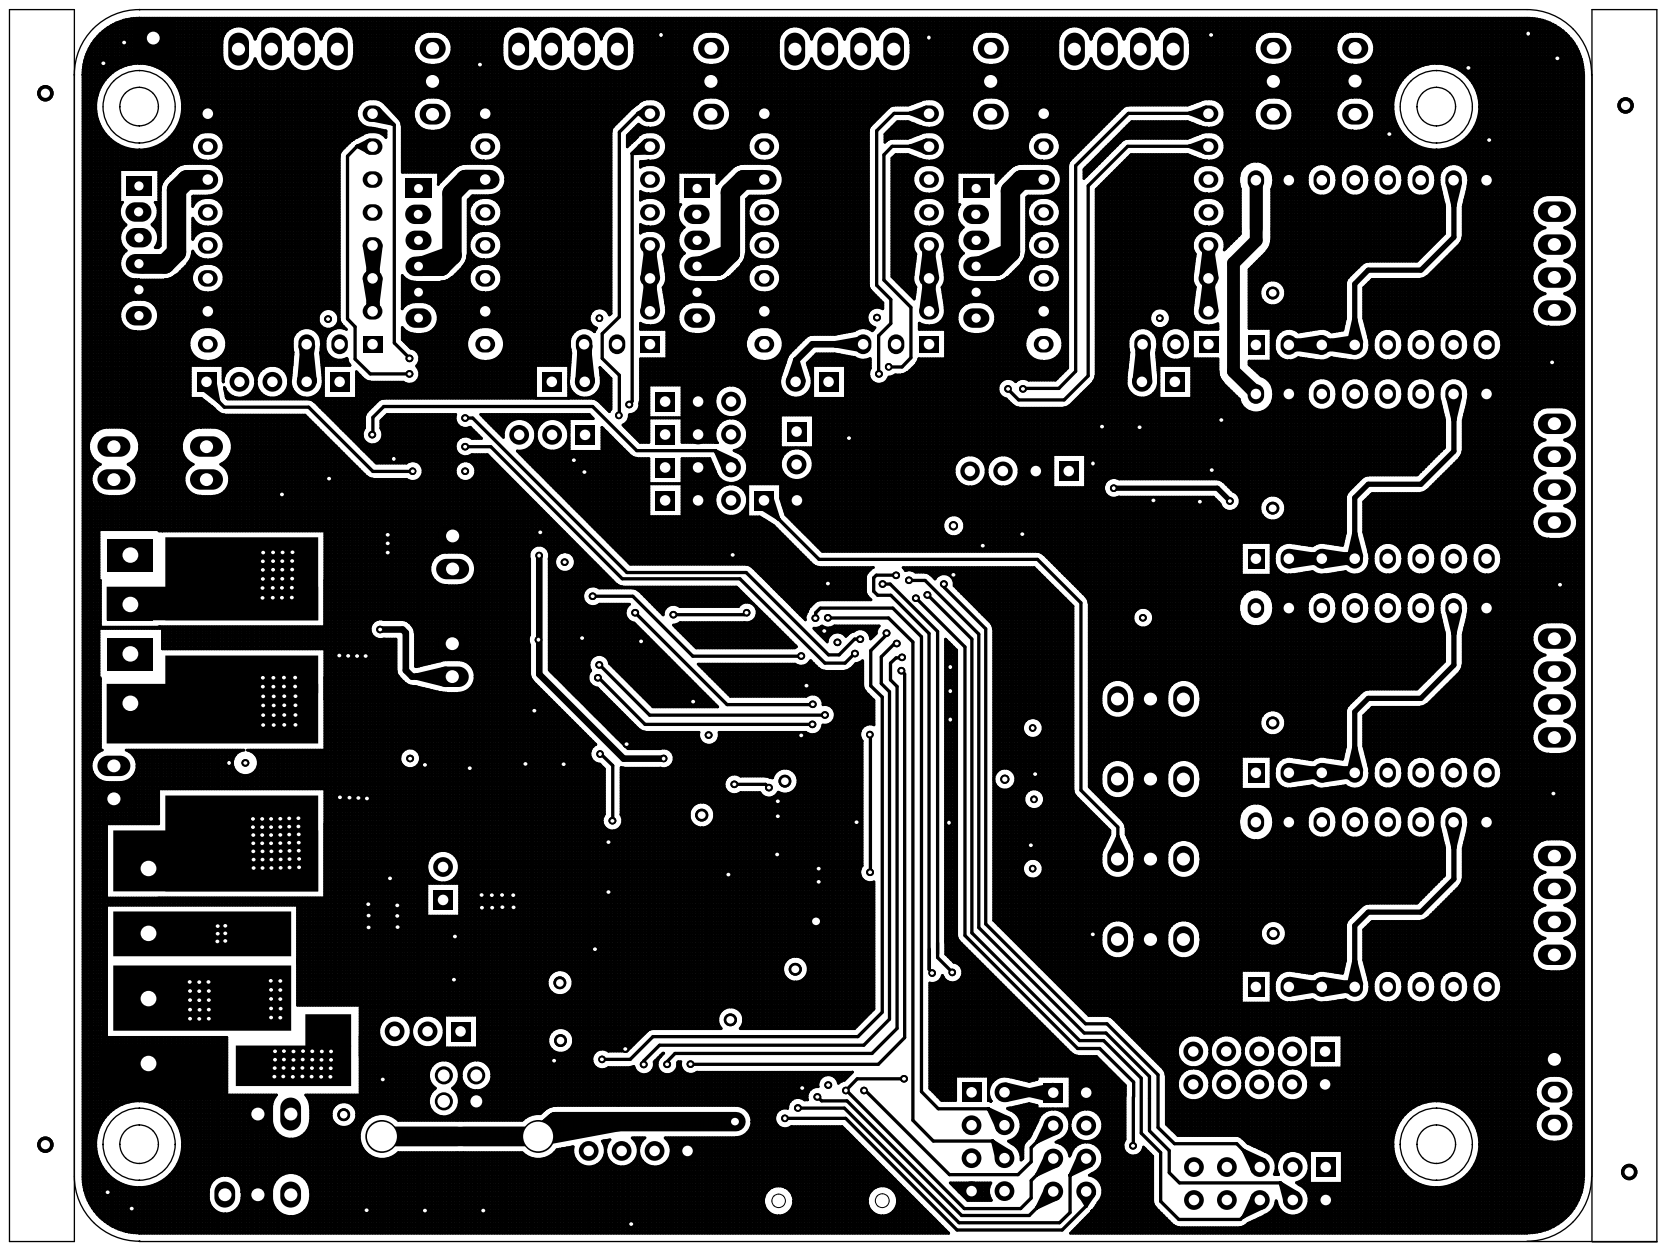
[picture p53: page 6]
