ZONESTAR3D/Control-Board/32bit/ZM3E4/ZM3E4V21/PCB_ZM3E4_V21.pdf

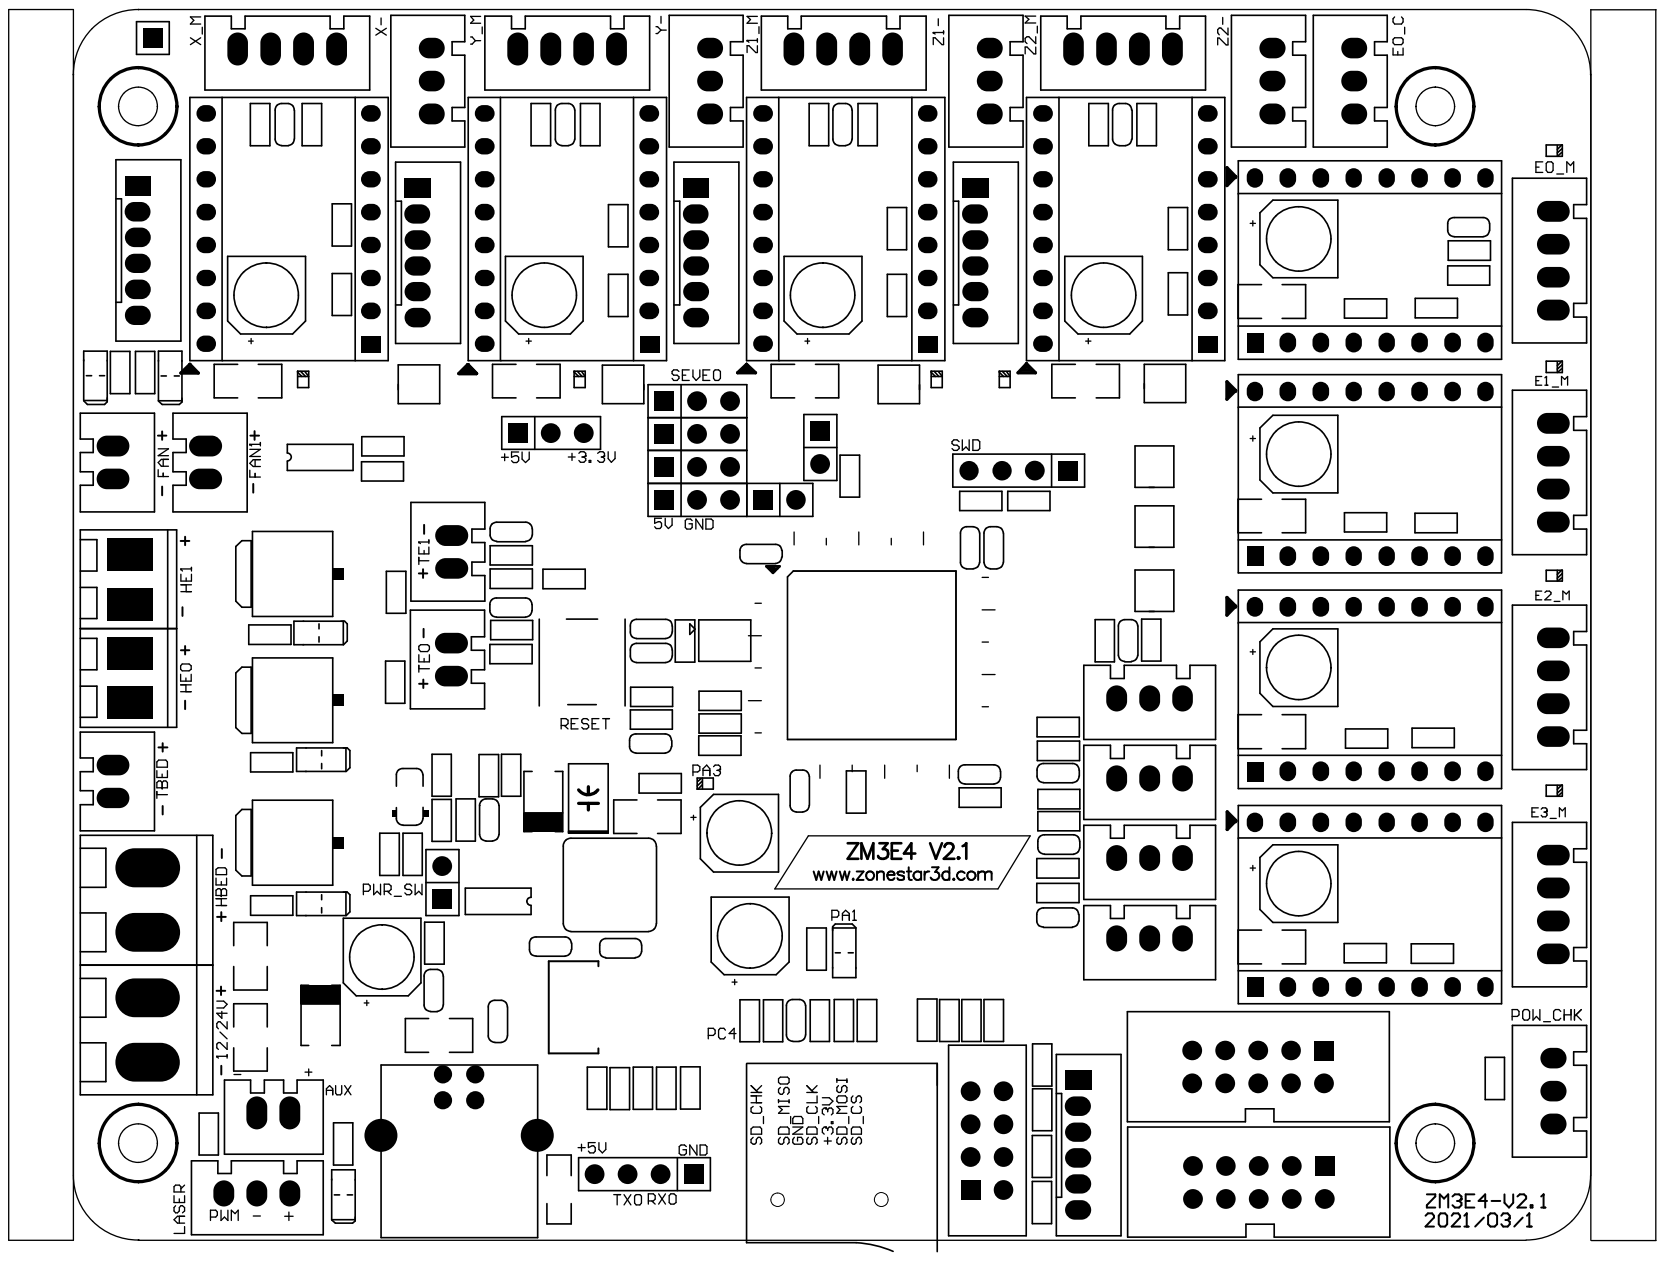
[picture p54: page 1]

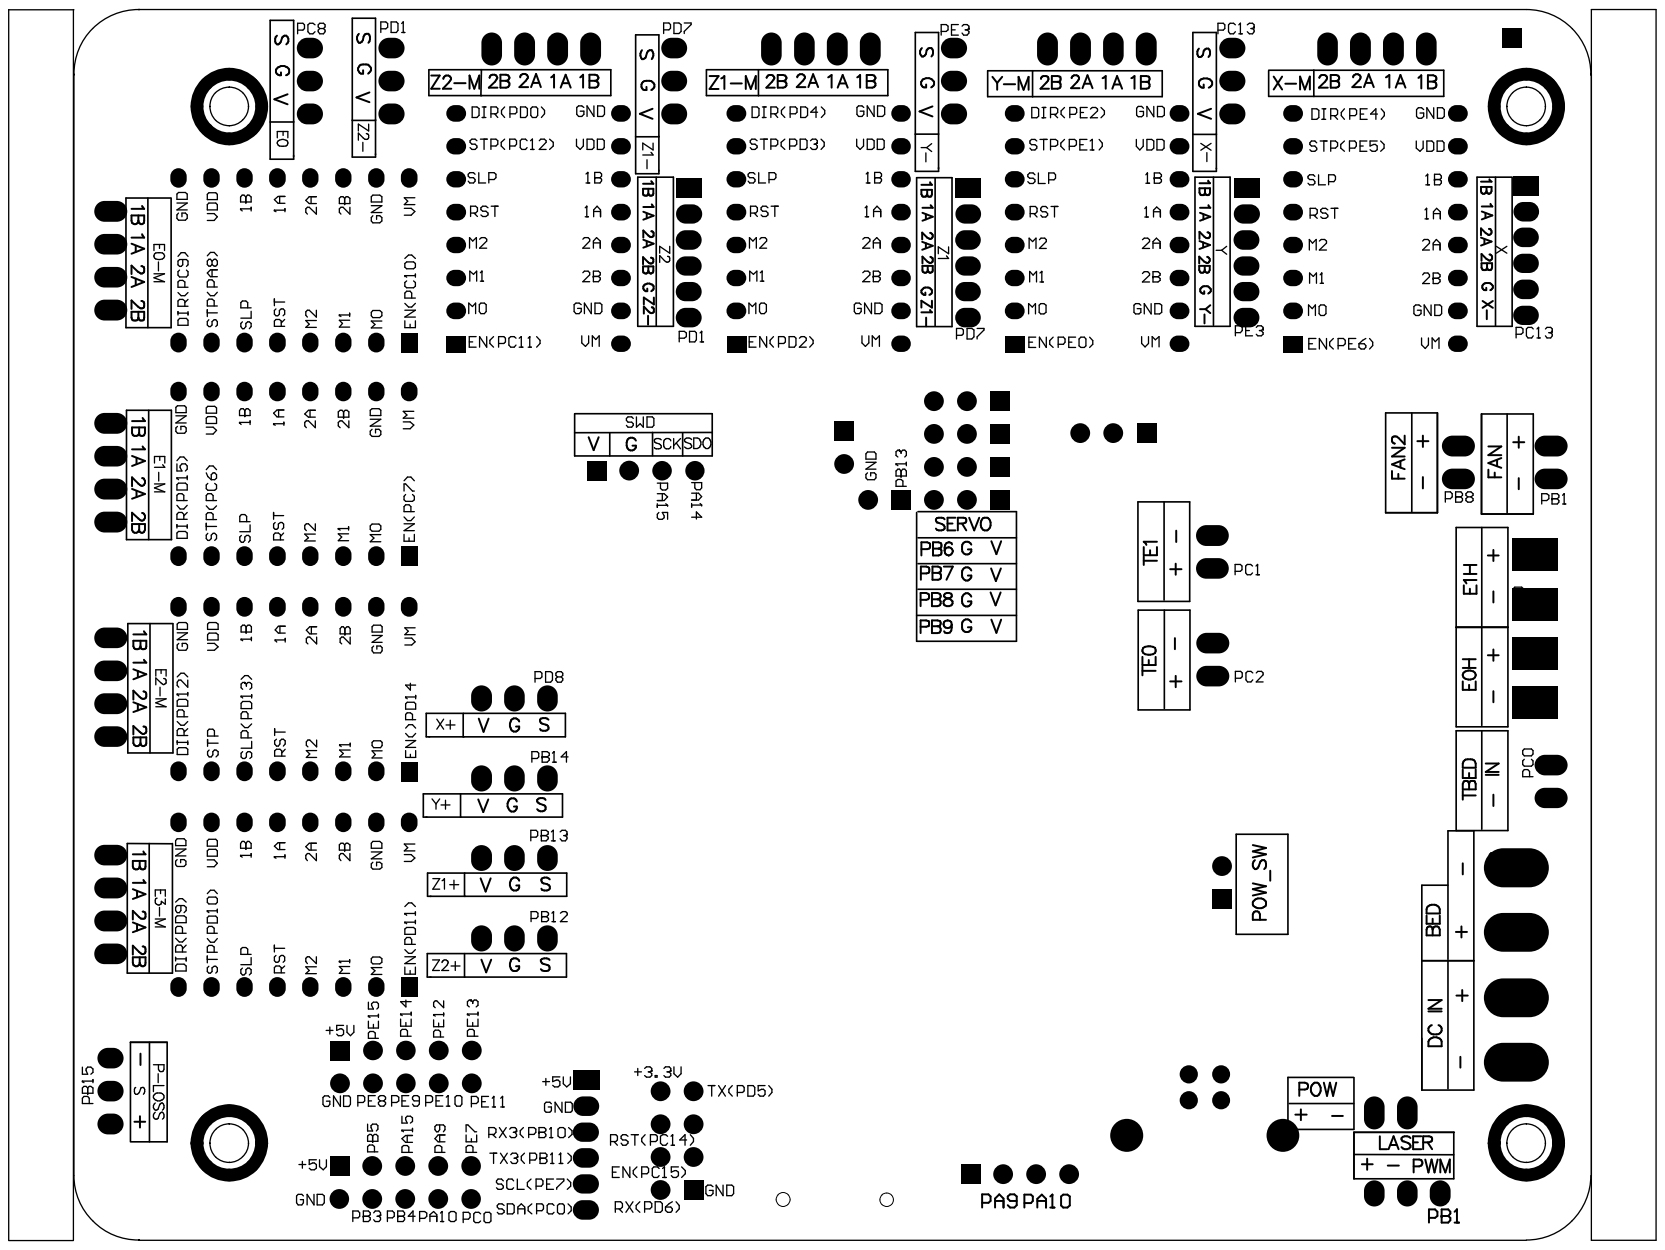
[picture p55: page 2]
