ZONESTAR3D/Control-Board/32bit/ZM3E4/ZM3E4V1/PCB_ZM3E4_V1.pdf

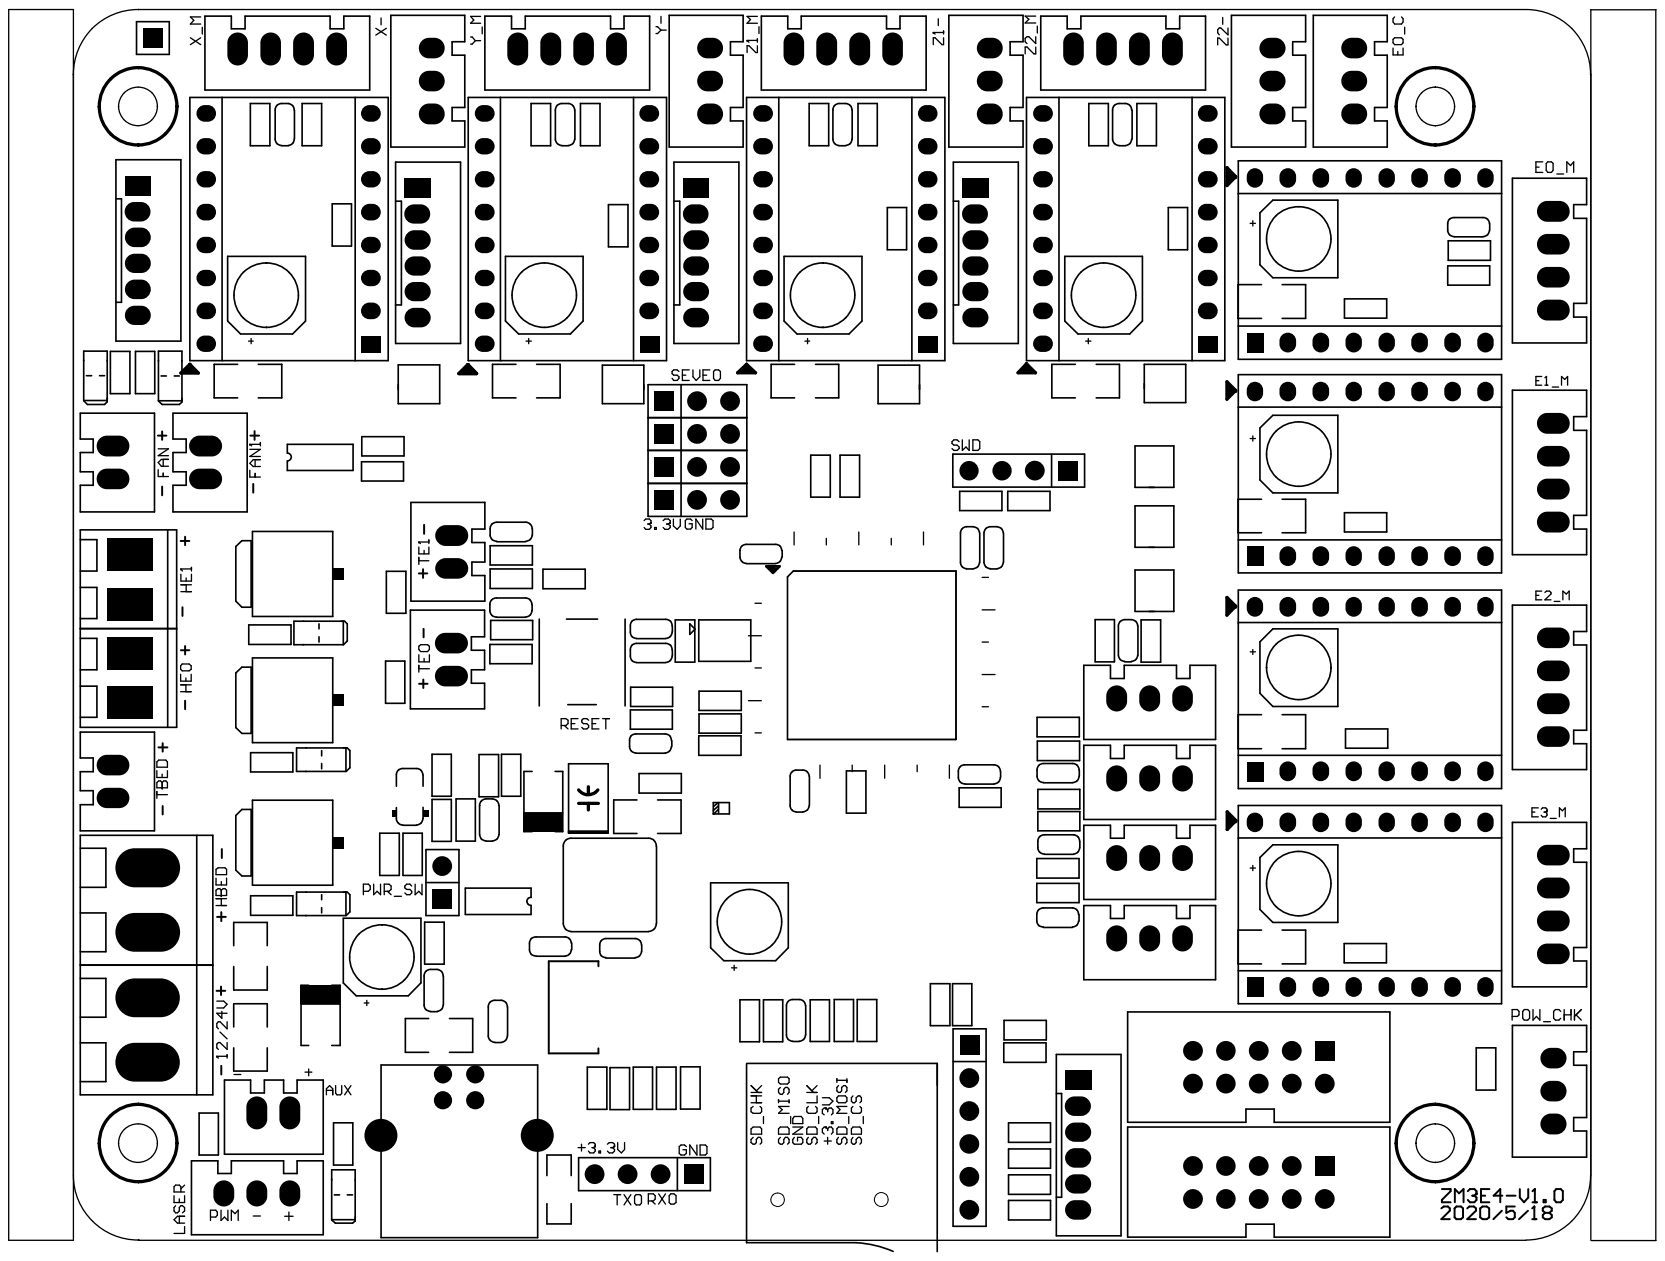
[picture p56: page 1]

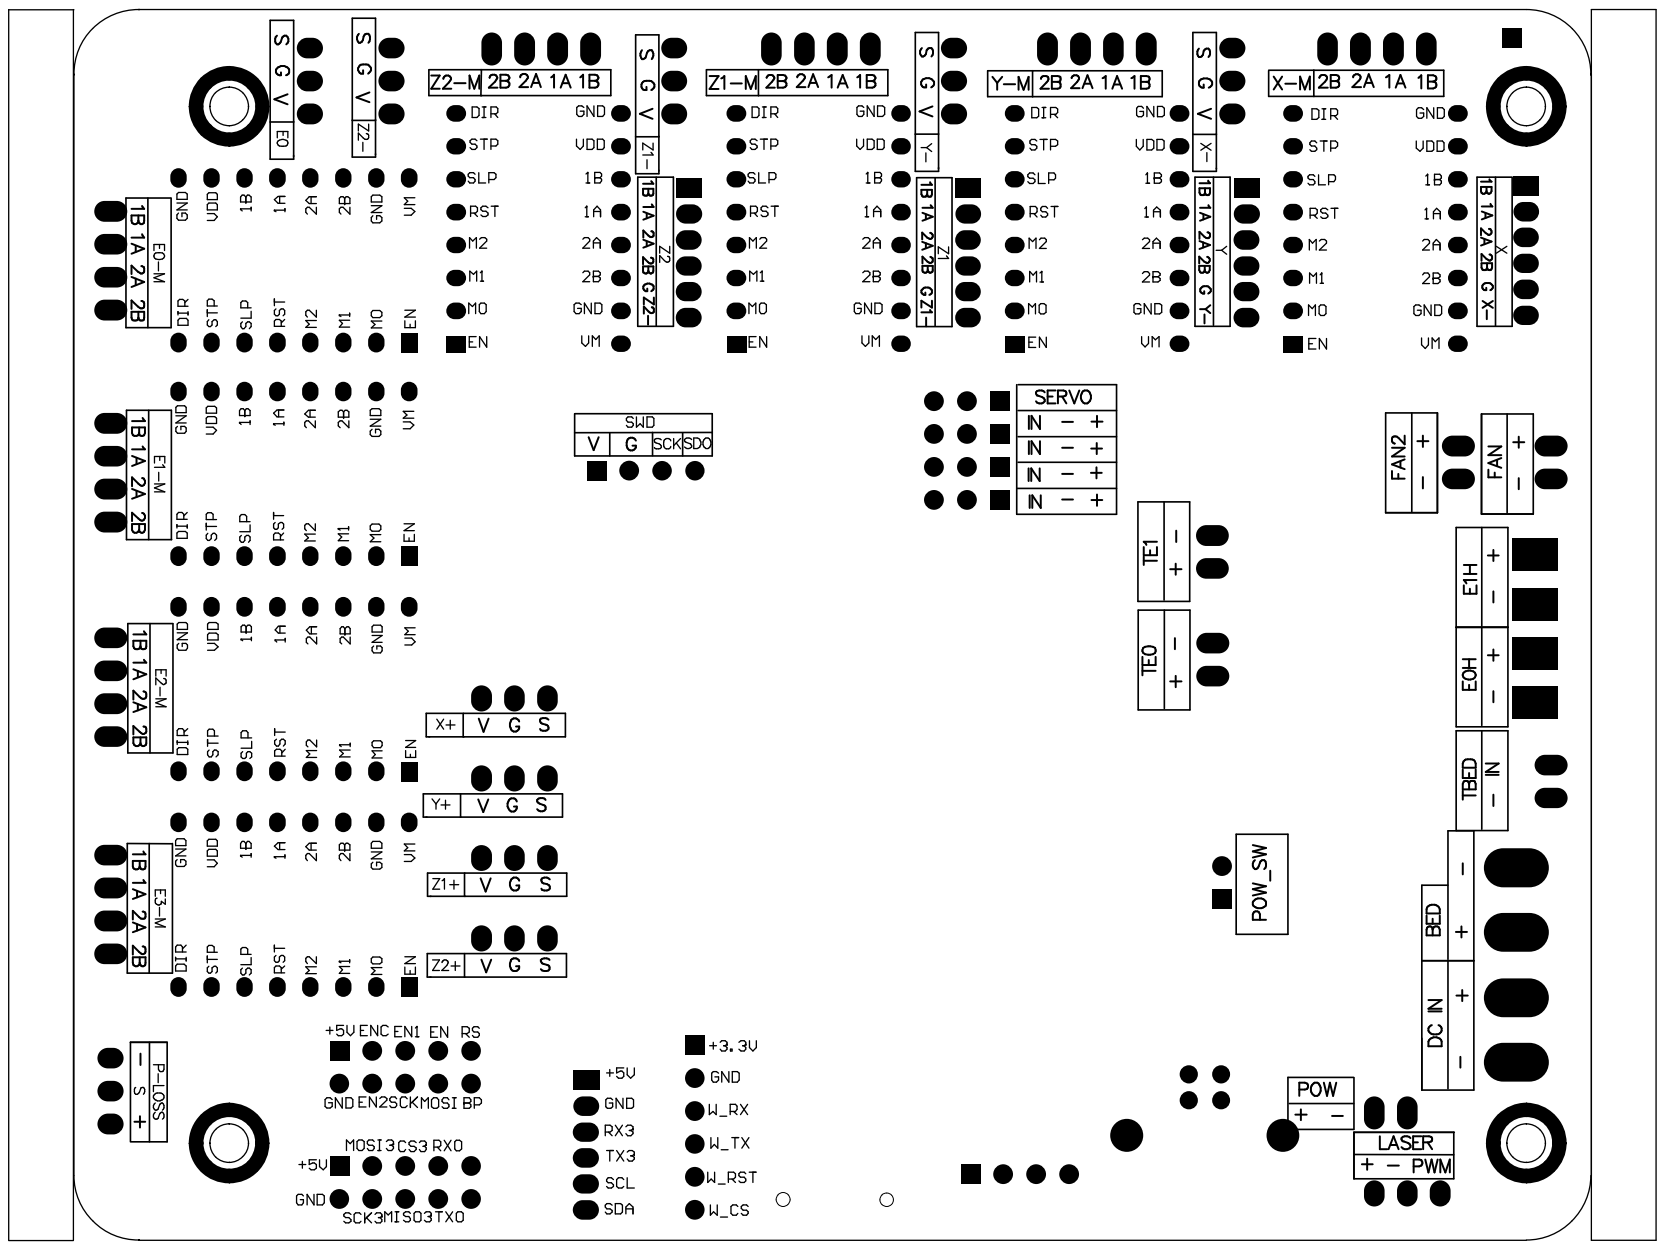
[picture p57: page 2]
