ZONESTAR3D/Control-Board/32bit/ZM3E4/ZM3E4V20/PCB_ZM3E4_V20.pdf

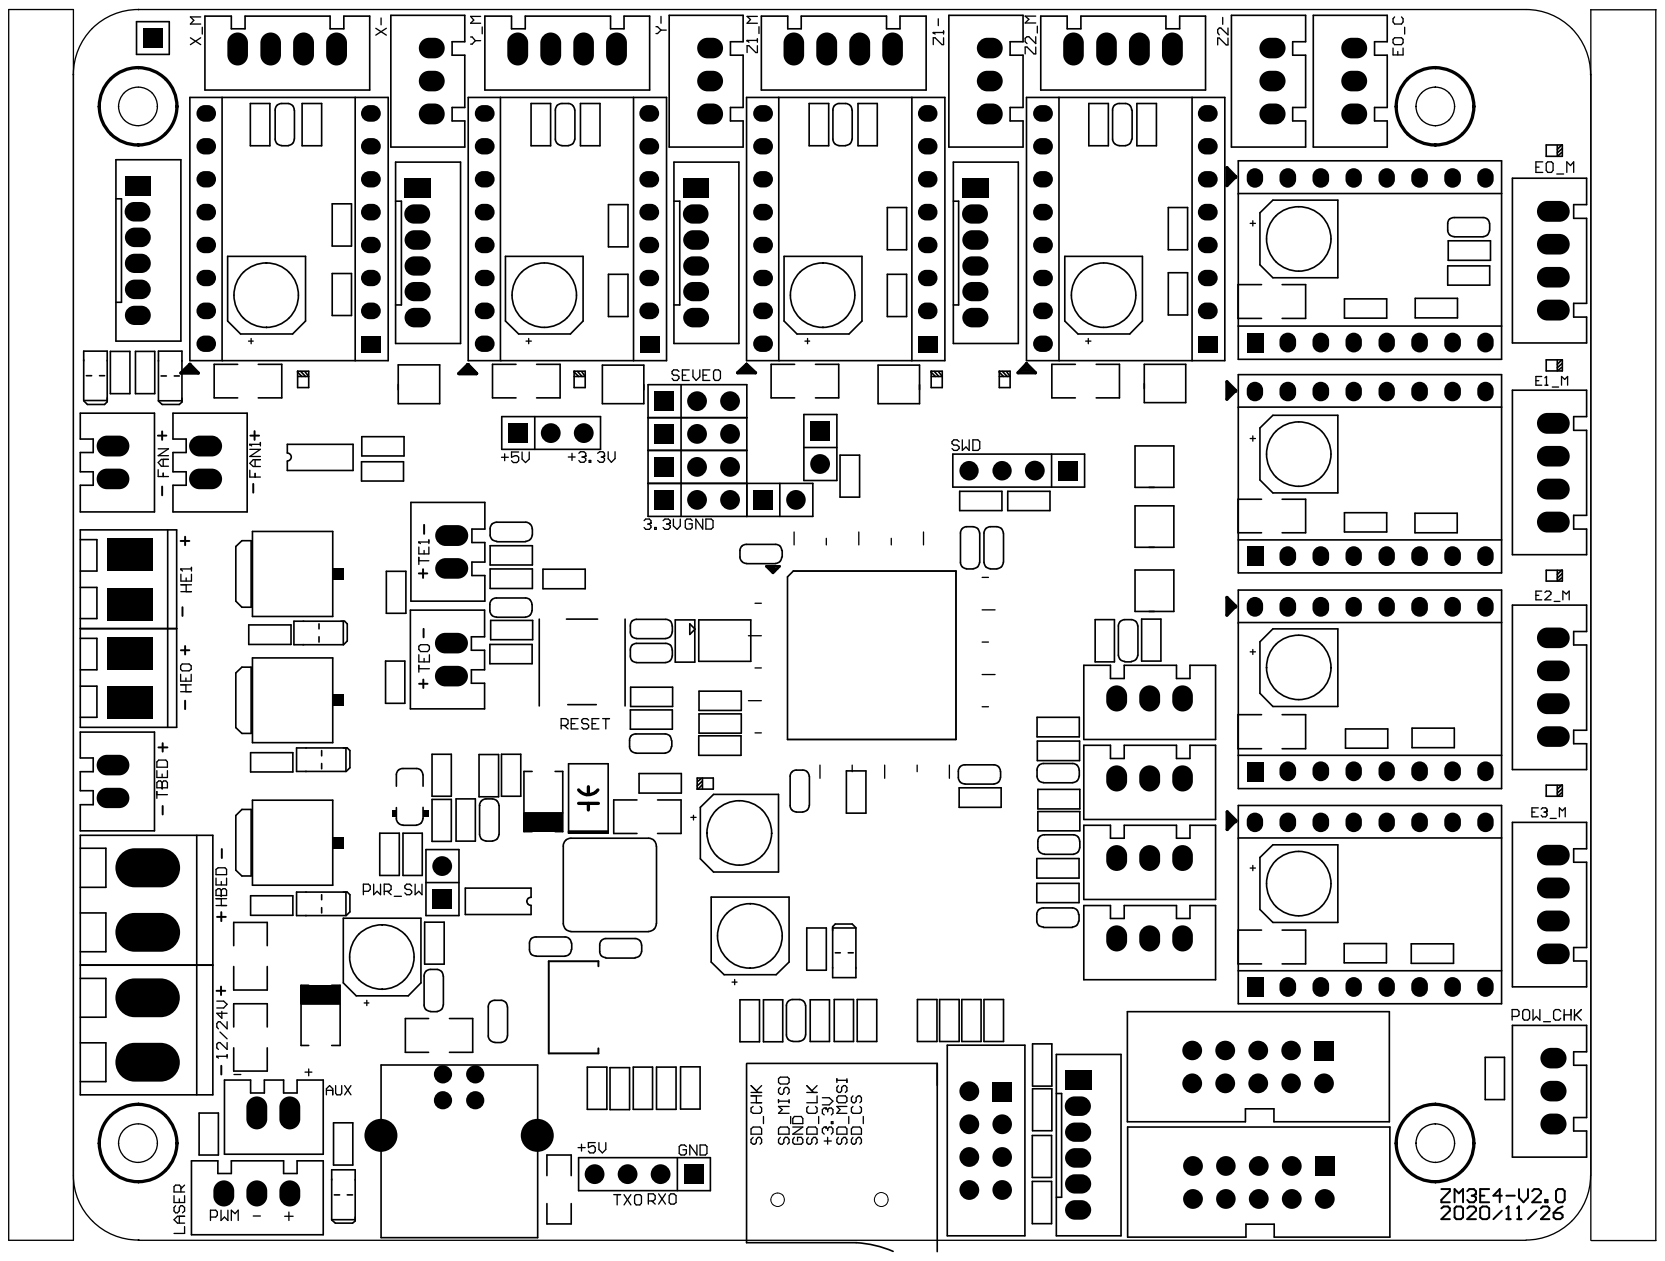
[picture p58: page 1]

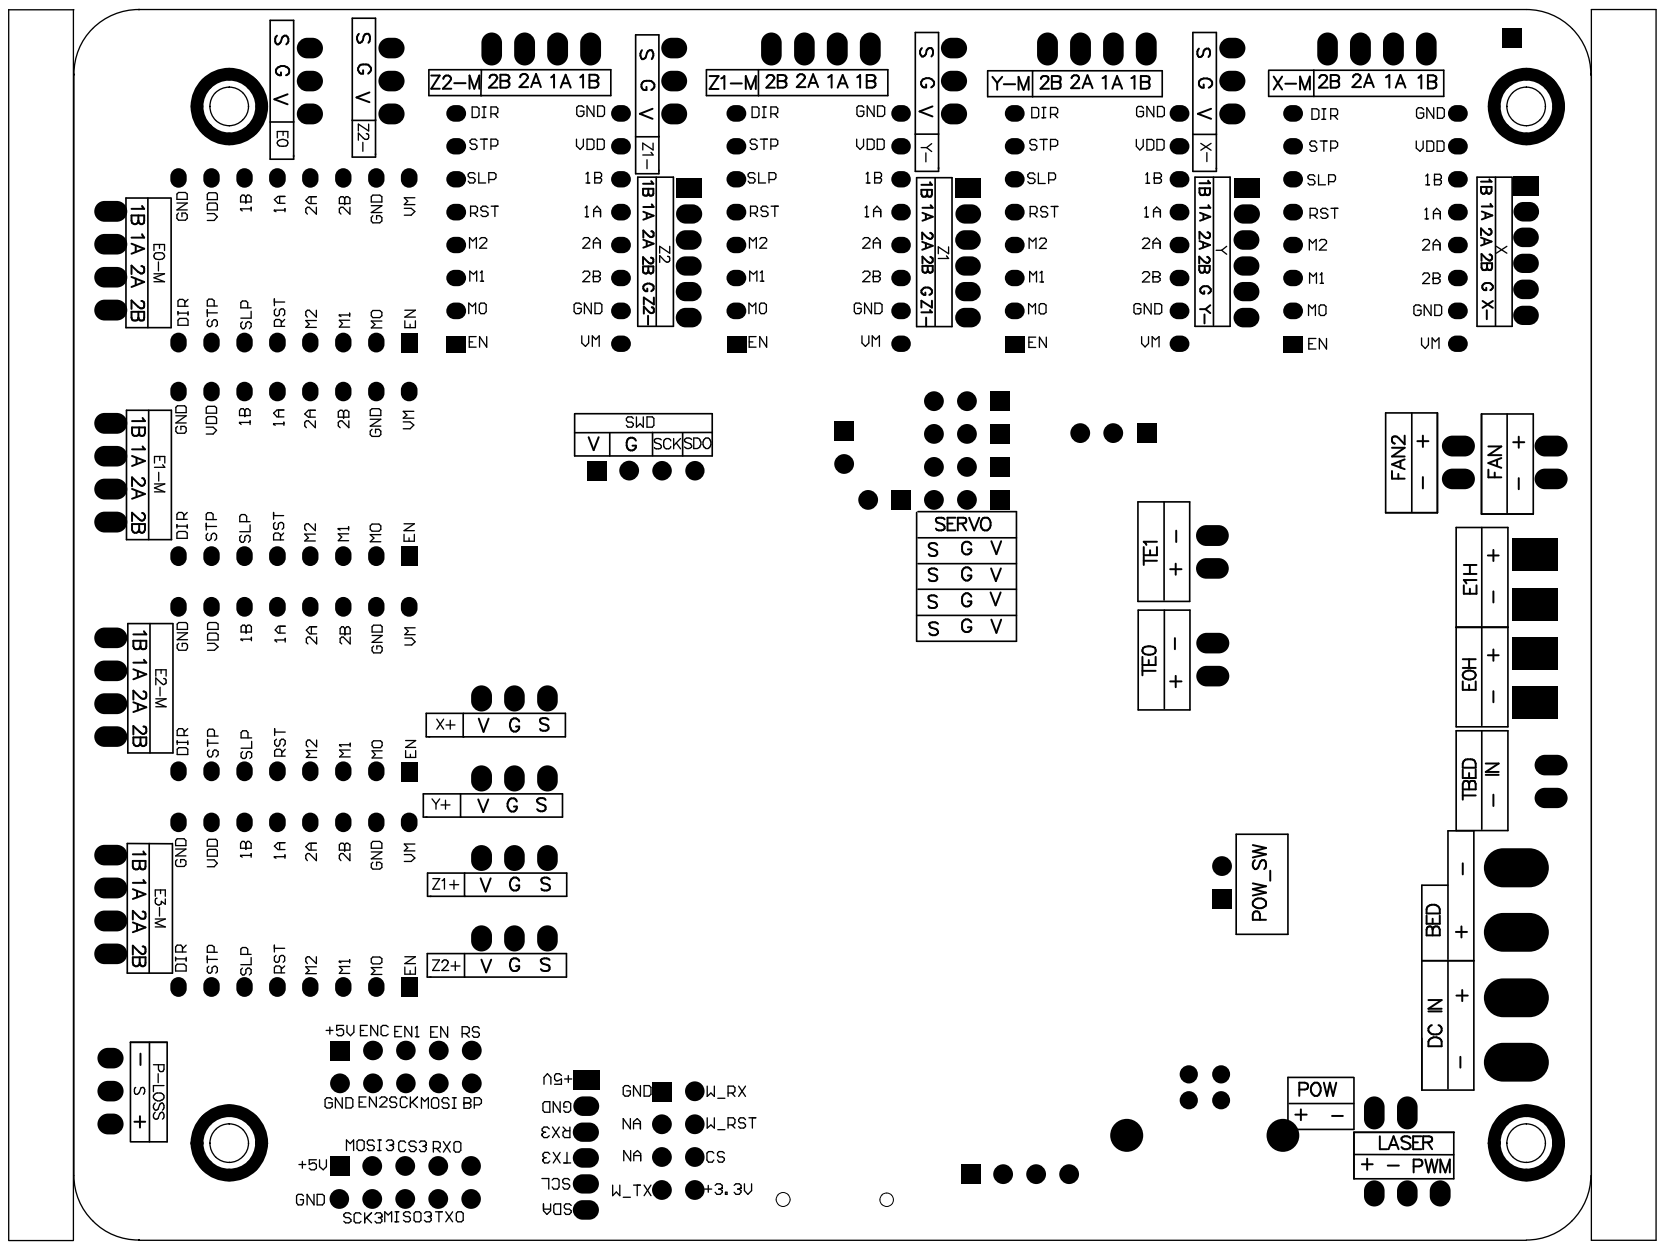
[picture p59: page 2]
