ZONESTAR3D/Control-Board/8bit/ZRIB/ZRIB_V2/ZRIB_V2_Schematic.pdf

# Power

### Vfb=0.8V

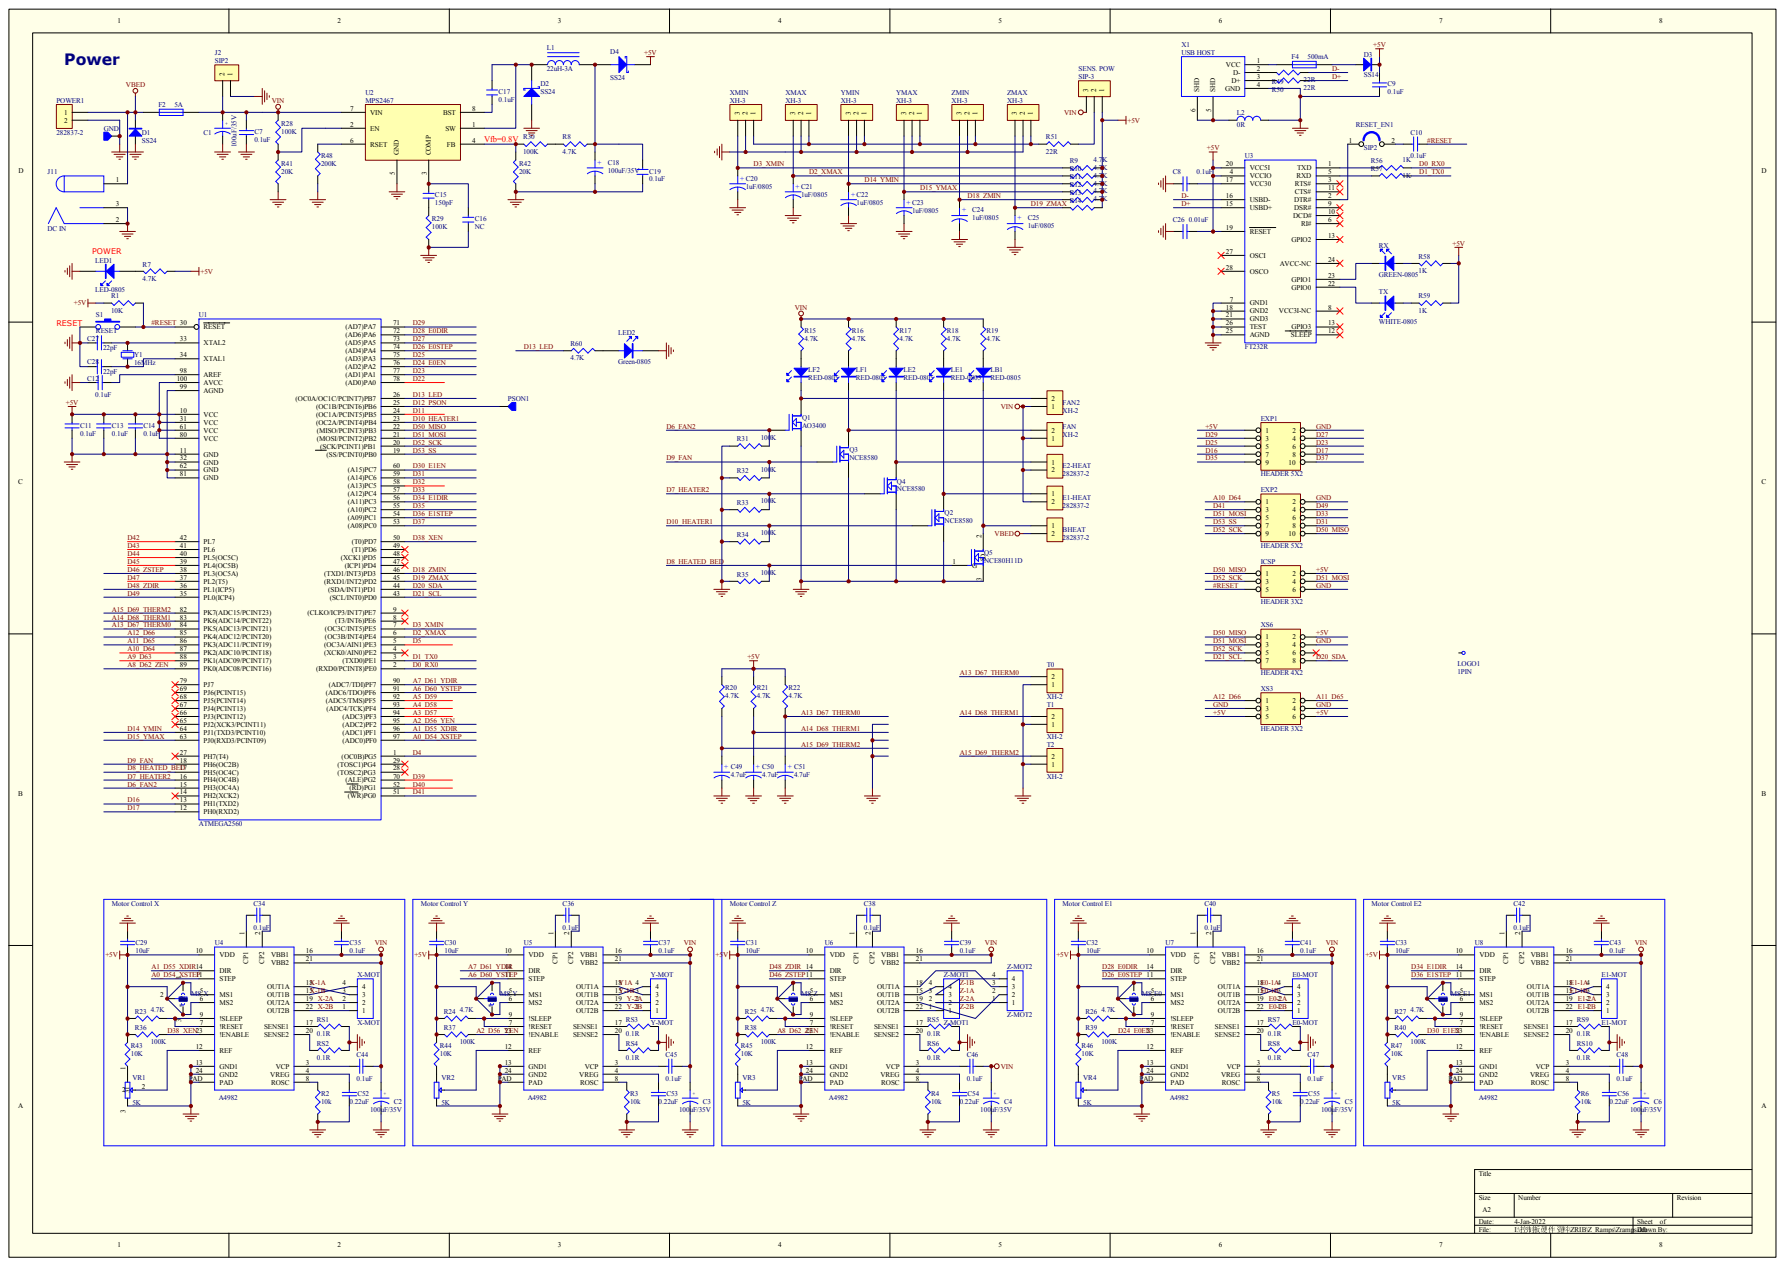
[picture p60: page 1]

D3_XMIN

D2_XMAX

D14_YMIN

D15_YMAX

D18_ZMIN
