ZONESTAR3D/Control-Board/(commit log)

2021-11-25 updata in 2021-11-25
    [zm3e4.stp]
2021-12-20 updata ZM3E4 PCB picture
2023-01-03 update ZM3E4 files
    [zm3e4.stp]
2024-01-26 update driver for PL2303
2024-10-29 update USB driver
