ZONESTAR3D/Control-Board/(notices)

Notices in the files:
32bit/ZM3E4/ZM3E4V1/pins_ZM3E4_V1_0.h:
This program is free software: you can redistribute it and/or modify
it under the terms of the GNU General Public License as published by
the Free Software Foundation, either version 3 of the License, or
(at your option) any later version.
